wojciechpaderewski/Nixie_alarm_clock/docs/main/skroty/skroty.tex

% Created 2024-10-16 śro 21:35
% Intended LaTeX compiler: pdflatex
\documentclass[../main.tex]{subfiles}

% \usepackage[a4paper, margin=3cm]{geometry}
% \usepackage{amssymb} // not working

\usepackage[T1]{fontenc}
\usepackage[utf8]{inputenc}
\usepackage{graphicx}
\usepackage{longtable}
\usepackage{wrapfig}
\usepackage{rotating}
\usepackage[normalem]{ulem}
\usepackage{amsmath}
\usepackage{capt-of}
\usepackage{hyperref}
\usepackage{siunitx}
\usepackage{float}
\usepackage[polish]{babel}

\graphicspath{{../}}
\author{Wojciech Paderewski}
\date{\today}
\title{Koncepcja ukladu}
\hypersetup{
 pdfauthor={Wojciech Paderewski},
 pdftitle={Koncepcja ukladu},
 pdfkeywords={},
 pdfsubject={},
 pdflang={Polish}}

\begin{document}

\section*{Wykaz ważniejszych oznaczeń i skrótów}
\addcontentsline{toc}{section}{Wykaz ważniejszych oznaczeń i skrótów}
NTP - Network Time Protocol, protokół czasu sieciowego \\
Wi-Fi - Wireless Fidelity, bezprzewodowa łączność \\
RTC - Real Time Clock, zegar czasu rzeczywistego \\
I2C - Inter-Integrated Circuit, interfejs komunikacyjny \\
JTAG - Joint Test Action Group, interfejs programowania \\
USB - Universal Serial Bus, uniwersalna magistrala szeregowa \\
\end{document}
