wojciechpaderewski/Nixie_alarm_clock/docs/main/budowa_ukladu/encoder/encoder.tex

% Created 2024-10-16 śro 21:35
% Intended LaTeX compiler: pdflatex
\documentclass[../../main.tex]{subfiles}

% \usepackage[a4paper, margin=3cm]{geometry}
% \usepackage{amssymb} // not working

\usepackage[T1]{fontenc}
\usepackage[utf8]{inputenc}
\usepackage{graphicx}
\usepackage{longtable}
\usepackage{wrapfig}
\usepackage{rotating}
\usepackage[normalem]{ulem}
\usepackage{amsmath}
\usepackage{capt-of}
\usepackage{hyperref}
\usepackage{siunitx}
\usepackage{float}
\usepackage[polish]{babel}

\graphicspath{{../}}
\author{Wojciech Paderewski}
\date{\today}
\title{Koncepcja układu}
\hypersetup{
 pdfauthor={Wojciech Paderewski},
 pdftitle={Koncepcja układu},
 pdfkeywords={},
 pdfsubject={},
 pdflang={Polish}}

\begin{document}

Jedynymi kryteriami wyboru enkodera obrotowego były napięcie zasilania oraz to, by posiadał on przycisk.
Wybrano encoder PEC12R\-41BBF\-S0012 firmy Bourns \cite{st:encoder}. Jest to 2-kanałowy encoder o rozdzielczości 12 impulsów na obrót. 
Jego napięcie robocze wynosi 5 V. Producent w karcie katalogowej informuje również, jakie filtry zastosować, aby zapobiec zakłóceniom.
Schemat zalecany przez producenta przedstawiono na rysunku \ref{fig:encoder_karta}.

\begin{figure}[H]
    \centering
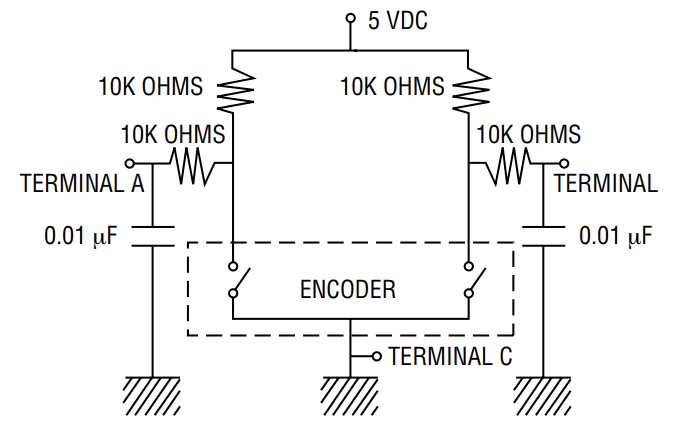
[picture p26: docs/main/budowa_ukladu/encoder/encoder_karta.png]
    
    \caption{Schemat filtrów zalecany przez producenta \cite{st:encoder}}
    \label{fig:encoder_karta}
\end{figure}

Dodatkowo dodano filtr dolnoprzepustowy przy przycisku enkodera, aby zapobiec drganiom styków i nie musieć implementować debouncingu w oprogramowaniu.
Schemat elektryczny podłączenia enkodera obrotowego przedstawiono na rysunku \ref{fig:encoder}.
\begin{figure}[H]
    \centering
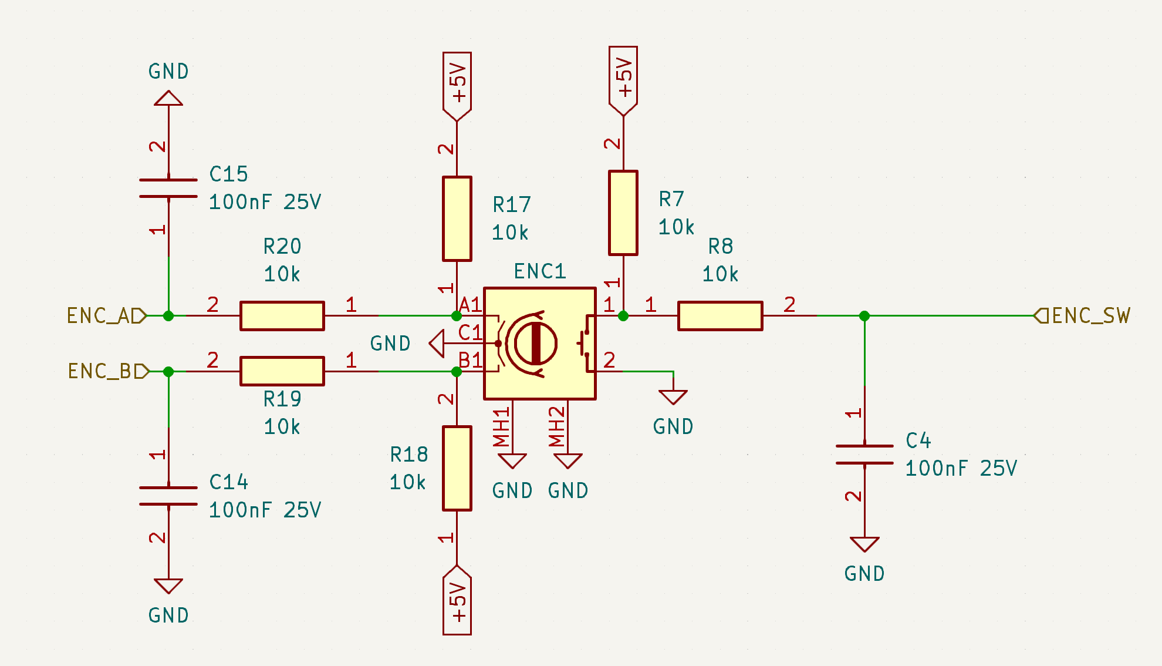
[picture p27: docs/main/budowa_ukladu/encoder/encoder.png]
    
    \caption{Schemat elektryczny enkodera obrotowego}
\end{figure}

\end{document}
