wojciechpaderewski/Nixie_alarm_clock/docs/raport/documentation.pdf

Kluczowe parametry zastosowanych lamp nixie

- Napięcie zapłonu: 170 V
- Napięcie pracy: 140 V
- Napięcie wygaszania: 120 V
- Prąd katodowy średni: 2 mA
- minimalny prąd katodowy: 1.5 mA
- maksymalny prąd katodowy: 2.5 mA

1
