wojciechpaderewski/Nixie_alarm_clock/docs/raport/raport.pdf

# Raport ze wstępnego etapu prac

## 1 Zdobycie kluczowego elementu projektu - lamp nixie

Udało się zakupić lampy nixie w ilości 6 sztuk. Są to lampy typu Z570N, produkcji niemieckiej. Był problem z dostępnością lamp, jednak udało się je zakupić używane w dobrym stanie w rozsądnej cenie.

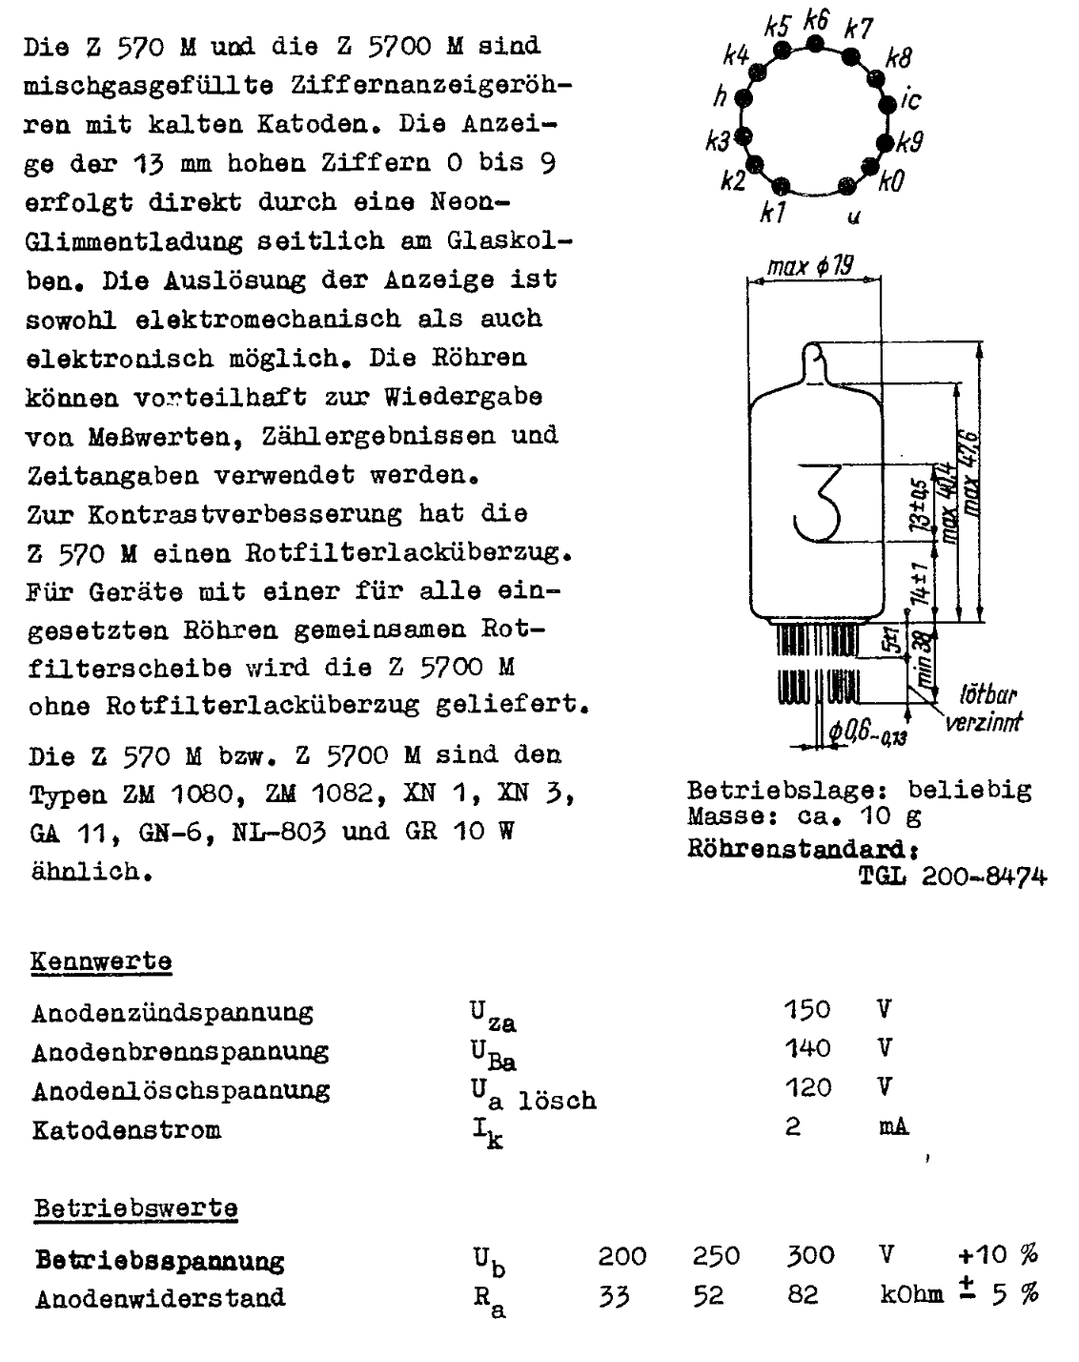
[picture p35: figure]

Rys. 1. Fragment dokumentacji lampy nixie Z570M

## 2 Opracowanie kluczowych założeń projektu

Zegar ma być zasilany przez USB-C co wymusza zaprojektowanie konwertera zasilania z 5V na 170V co jest zadaniem trudniejszym niż z 12V na 170V

Konwerter ma mieć możliwość programowej regulacji jasności wyświetlaczy, co zostanie uzyskane poprzez regulowany dzielnik napięcia w obwodzie sprzężenia zwrotnego sterownika konwertera

By zrealizować funkcje budzika, zegar ma bedzie wyposażony w mały buzzer który będzie generował dźwięk alarmu, będzie również możliwość wykorzystania zewnętrznego głośnika bluetooth

By nie zaburzać estetyki zegara, przycisk wyłączania alarmu bedzie odzielnym modułem komyunikującym się z zegarem po jakimś prostym protokole który będzie zużywał jak najmniej energii, ponieważ przycisk będzie zasilany z baterii

Zegar ma być wyposażony w moduł WiFi, który będzie umożliwiał sterowanie zegarem z poziomu

1

Home Assistanta, wykorzystane będą prawodopodobnie dwa mikrokontrolery, jeden do obsługi wyświetlaczy i przycisków, drugi n którym będzie zainstalowany ESPhome, który będzie komunikował się z Home Assistantem, a mikrokontrolery będą się komunikowac za pomocą UARTu

## 3 Wstępny model 3D zegara

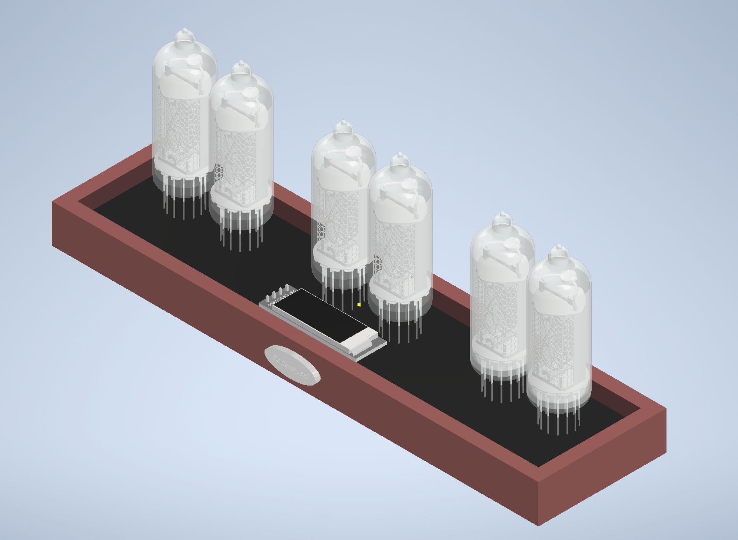
[picture p36: figure]

Rys. 2. Wstępny model 3D zegara rzut z góry

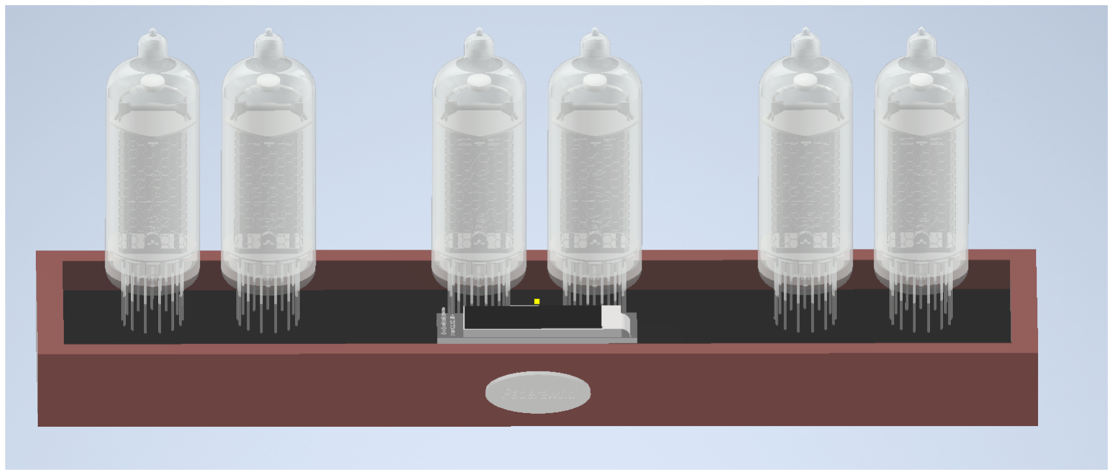
[picture p37: figure]

Rys. 3. Wstępny model 3D zegara rzut z przodu

Model jest tylko wstępnym zarysem, aby zwizualizować jakie materiały będą użyte i jak to bedzie wyglądać.
Materiały:
- Obudowa: drewno dębowe
- Pokrywa: szkło hartowane lub plexi (przyciemniane) ma być widoczna płytka drukowana
- Podstawa od spodu ma posiadać nóżki antypoślizgowe o odpowiedniej wysokości, by były widoczne ledy które będą od spodu podświetlać zegar

## 4 Początek projektowania konwertera

2
