wojciechpaderewski/Nixie_alarm_clock/docs/main/realizacja/obliczenia_mocy/obliczenia_mocy.pdf

By móc zaprojektować odpowiednie zasilanie dla całego układu, należy obliczyć szacunkową moc potrzebną do zasilania wszystkich komponentów. Poza lampami Nixie, najbardziej obciążającym elementem będzie pasek LED oraz mikrokontroler, pozostałe elementy będą pobierały znikome ilości prądu.
Założono maksymalną długość paska LED na 30 cm. Z deklaracji producenta paska LED wynika, że moc na metr wynosi 18W, co daje:

PLED = 18W m⁻¹
- 0.3 m = 5.4W | (0.1)

Następnie obliczono prąd potrzebny do zasilenia paska LED przy napięciu 5 V:

ILED =

PLED

ULED

=

5.4W
5 V
= 1.08 A | (0.2)

W dalszej kolejności obliczono moc potrzebną do zasilania mikrokontrolera ESP32-S3. Według producenta maksymalny pobór prądu wynosi 340 mA, co przy napięciu zasilania 3.3 V daje:

PESP32 = 340 mA · 3.3 V = 1.122W | (0.3)

Następnie policzono prąd pobierany przez wszystkie lampy, których jest 6 sztuk, przy prądzie katodowym 2 mA każda, co daje:

INixie = 6 · 2 mA = 12 mA | (0.4)

Jednak należy dodać jeszcze prąd potrzebny do zasilania kropek oraz separatorów, oszacowano prąd kropki na 1 mA oraz separatora na 1 mA, co daje:

INixie = 6 · 2 mA + 6 · 1 mA + 2 · 1 mA = 20 mA | (0.5)

Dalszym krokiem było obliczenie mocy potrzebnej do zasilania lampy nixie, przy napięciu 220 V oraz prądzie 20 mA, zakładając sprawność przetwornicy na poziomie 70 %:

PNixie =

UNixie · INixie
Sprawność =

220 V · 20 mA
0.7
= 6.29W | (0.6)

Pozostałe komponenty będą pobierały znikome ilości prądu, więc nie będą brane pod uwagę w obliczeniach. Szacunkowa moc potrzebna do zasilania całego układu wynosi:

Pcałkowita = PLED + PESP32 + PNixie = 5.4W + 1.122W + 6.29W = 12.812W (0.7)

Sumarycznie szacunkowa moc potrzebna do zasilania całego układu wynosi około 13W,

1
