wojciechpaderewski/Nixie_alarm_clock/docs/main/budowa_ukladu/12V_to_HV_conv/12V_to_HV_conv.pdf

Przetwornica impulsowa wysokiego napięcia jest najtrudniejszym do zaprojektowania elementem układu. Ma ona posiadać regulowane programowo napięcie wyjściowe, co dodatkowo komplikuje projekt. Nie może być również użyta zbyt duża cewka, ponieważ celem jest stworzenie niskiego urządzenia.

### 0.0.1 Założenia projektowe

- Napięcie wejściowe: 12 V
- Napięcie wyjściowe: 130-220 V
- Prąd wyjściowy: 20 mA
- 0.1 V tętnienia napięcia wyjściowego

### 0.0.2 Wybór układu scalonego

Wybrano układ LM3488 produkcji Texas Instruments, który jest układem przeznaczonym do budowy przetwornic typu Boost oraz Flyback. Jest to układ high efficiency, co jest powodem dla którego został wybrany [1].
Jako początkowe założenie przyjęto częstotliwość przełączania 400 kHz zgodnie z domyślną wartością w nocie katalogowej układu, ale możliwe jest zwiększanie częstotliwości do 1 MHz, co pozwala na zmniejszenie rozmiarów cewki oraz kondensatorów, natomiast może to pogorszyć sprawność układu, ponieważ według karty katalogowej wraz ze wzrostem częstotliwości spada wzmocnienie układu, co przekłada się na mniejszą sprawność. Podczas projektowania wzorowano się na schemacie z karty katalogowej, który przedstawiono na rysunku 0.1.

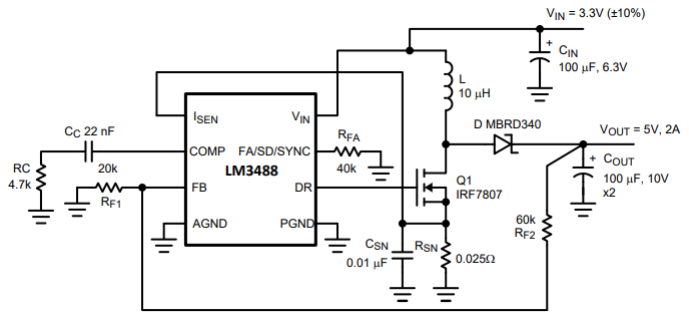
[picture p48: figure]

Figure 0.1: Schemat układu z karty katalogowej [1]

### 0.0.3 Dobór cewki

Wartość prądu cewki oszacowano na podstawie założonego prądu wyjściowego:

Il =

Vout · Iout

Vin

=

220 · 0.02
12
≈ 0.36 mA | (0.1)

Dodatkowe 30% prądu wyjściowego zostało dodane jako tętnienia prądu, co pozwala oszacować wartość maksymalnego prądu cewki:

Ipeak = (1 + 0.3) · Il = 1.3 · 0.36 ≈ 0.468 A | (0.2)

Wynika z tego, że potrzebna jest cewka o prądzie przewodzenia większym niż 0.5 A. Obliczono wypełnienie sygnału PWM, na podstawie wzoru:

D220 =

Vout − Vin

Vout

=

220 − 12
220
≈ 0.945 | (0.3)

D130 =

Vout − Vin

Vout

=

130 − 12
130
≈ 0.908 | (0.4)

Zgodnie z kartą katalogową układu LM3488, cewka powinna mieć wartość określaną wzorem:

L > D(1 − D)Vin

2fswIout

(0.5)

Według dokumentacji Iout podczas obliczeń powinno stanowić 30% minimalnej wartości prądu wyjściowego:
Iout = 0.3 · 20 mA = 6 mA | (0.6)

Dla napięcia wyjściowego 220 V oraz napięcia wejściowego 12 V oraz częstotliwości 400 kHz otrzymano wartość cewki:

L220 >

0.945 · (1 − 0.945) · 12
2 · 400000 · 0.006
≈ 128.9 µH | (0.7)

Natomiast dla napięcia wyjściowego 130V oraz napięcia wejściowego 12 V oraz częstotliwości 400 kHz otrzymano wartość cewki:

L130 >

0.908 · (1 − 0.908) · 12
2 · 400000 · 0.006
≈ 209.5 µH | (0.8)

Napotkano problem z doborem cewki, ponieważ nie udało się znaleźć w sklepie cewki o wartości powyżej 200 µH w rozsądnej cenie i odpowiednich rozmiarach. Dlatego zdecydowano się na zastosowanie cewki o wartości 180 µH, która jest najbliższą wartością dostępną w sklepie. Wartość graniczna prądu cewki wynosi 0.9 A, co jest wystarczającym zapasem. Wybrana cewka ma rezystancję 6.3 mΩ. Moc strat w cewce wynosi:

Pl = I

2

peak · R = 0.468²

- 0.0063 ≈ 1.4 mW | (0.9)

W celu osiągnięcia założonego zakresu napięcia wyjściowego z użyciem wybranej cewki, zdecydowano się na zwiększanie częstotliwości przełączania do 500 kHz. Obliczono wartość cewki dla napięcia wyjściowego 130 V oraz napięcia wejściowego 12 V oraz częstotliwości 500 kHz:

L220 >

0.945 · (1 − 0.945) · 12
2 · 500000 · 0.006
≈ 103.1 µH | (0.10)

L130 >

0.908 · (1 − 0.908) · 12
2 · 500000 · 0.006
≈ 167.6 µH | (0.11)

Z obliczeń wynika, że zwiększanie częstotliwości pozwala na zmniejszenie wartości cewki, co pozwala na zastosowanie cewki o wartości 180 µH.

### 0.0.4 Dobór kondensatorów

Według zaleceń z karty katalogowej w przetwornicy powinny być zastosowane kondensatory o jak najniższym ESR, dlatego odrzucono kondensatory elektrolityczne na rzecz kondensatorów ceramicznych, które mają bardzo niski ESR, tak mały że producent nie podaje tej wartości w notach katalogowych, gdyż jest ona zbyt mała by miała znaczenie.

Jednak problemem jest znalezienie kondensatorów ceramicznych pracujących przy wysokim napięciu, mimo tego został znaleziony kondensator ceramiczny o wartości 2.2 µF i napięciu pracy
do 250 V.
W obliczeniach należy uwzględnić spadek pojemności kondensatora wraz ze wzrostem napięcia. Wartości spadku pojemności dla kondensatora ceramicznego odczytano z [st:ceramic-capacitor].


Figure 0.2: Spadek pojemności kondensatora ceramicznego wraz ze wzrostem napięcia [2]

Wybrany kondensator jest klasy 2, wykonany z materiału X7R, co oznacza, że jego pojemność spadnie w przybliżeniu o 30% dla napięcia 220 V. Zdecydowano się na zastosowanie 2 kondensatorów o wartości 2.2 µF połączonych równolegle w celu zminimalizowania tętnień napięcia wyjściowego. Ostatecznie pojemność oszacowana na:

C220 = 2 · (1 − 0.3) · 2.2 µF = 3.08 µF | (0.12)

Obliczono tętnienia dla dobranych wartości kondensatorów:

∆V220 =

Vout
2 ·

Vout
Iout
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
0.02 · 3.08µF

·

0.945
500000
≈ 6.1 mV | (0.13)

∆V130 =

Vout
2 ·

Vout
Iout
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
0.02 · 3.08µF

·

0.908
500000
≈ 5.89 mV | (0.14)

Wartości tętnień jest mniejsza niż założone 0.1 V, co oznacza, że dobrano odpowiednie wartości kondensatorów.

### 0.0.5 Dobór diody

Oszacowano prąd diody na podstawie wzoru z karty katalogowej:

Id =

Iout
1 − D

+ ∆Iout =

0.02
1 − 0.945
+ 0.006 ≈ 0.37 A | (0.15)

Dioda powina mieć prąd przewodzenia większy niż 0.4 A oraz być diodą szybko przełączającą, by zminimalizować straty w układzie.
Zdecydowano się na zastosowanie diody ES1G firmy Onsemi, która jest diodą super szybką, o prądzie przewodzenia 1 A, co jest wystarczające dla tego zastosowania. Dioda ta ma maksymalne napięcie wsteczne 400 V, co pozwala na bezpieczne zastosowanie w tym układzie.

### 0.0.6 Dobór tranzystora

Można założyć że prąd tranzystora to prąd cewki, czyli 20 mA. Zgodnie z kartą katalogową tranzystor powinien mieć następujące parametry:

- Napięcie minimalnie drain-source: 250 V
- Jak najmniejszy RDS(on)
- Prąd przewodzenia większy niż 0.5 A
- Niskie napięcie progowe VTH
- Jak najmniejszy ładunek bramki
- Wymaganego prąd bramki mniejszego niż 1 A

Zdecydowano się na zastosowanie tranzystora N-Channel MOSFET TPH5200FNH firmy Toshiba, który ma następujące parametry:

- Napięcie drain-source: 250 V
- RDS(on)

: 44 mΩ

- Prąd przewodzenia: 26 A
- Napięcie progowe: 2 V
- Ładunek bramki: 22 nC
- Rozpraszana moc: 2.5W

Średni prąd bramki potrzebny do załączenia tranzystora można obliczyć na podstawie wzoru:

Ig = Qg · fsw = 22 nC · 500000 = 11 mA | (0.16)

Tranzystor ten spełnia wszystkie założenia, a także ma bardzo niskie RDS(on)

, co pozwala na
zminimalizowanie strat w układzie. Moc wydzielana na tranzystorze można obliczyć na podstawie wzoru:

Pmos = I

2
l
- RDS(on) = 0.468²
- 0.044 ≈ 0.01W | (0.17)

Moc jest bardzo niska, co oznacza, że tranzystor nie będzie się nagrzewał, a także nie będzie wymagał radiatora.

### 0.0.7 Ustawienie napięcia wyjściowego

Napięcie wyjściowe będzie regulowane, dlatego zdecydowano się na zastosowanie potencjometru cyfrowego włączonego w obwód sprzężenia zwrotnego. Potencjometr cyfrowy będzie się komunikował z mikrokontrolerem za pomocą magistrali I2C, co pozwoli na programowe ustawianie napięcia wyjściowego, by regulować jasność lamp.
Wybrano potencjometr cyfrowy MCP4018T-103E/LT firmy Microchip, który ma 128 poziomów ustawień, co pozwala na dokładne ustawienie napięcia wyjściowego, wybrano wartość 10 kΩ, co pozwala na uzyskanie odpowiedniego zakresu ustawień napięcia wyjściowego.
Zgodnie z kartą katalogową napięcie na pinie FB powinno wynosić 1.26 V, napięcie to oznacza, że napięcie wyjściowe jest odpowiednie. Po przetestowaniu kilku kombinacji zdecydowano się na zastosowanie następujących rezystorów:
- Rf b1 = 2.49 MΩ

- Rf b2 = 14.39 kΩ

Obliczone napięcie na wyjściu dla potencjometru z nastawą 10 kΩ:

Vout = 1.26 · (1 + Rf b1

Rf b2 + Rpot

) = 1.26 · (1 + | 2.49 MΩ
14.39 kΩ + 10 kΩ) ≈ 130.4 V | (0.18)

Obliczone napięcie na wyjściu dla potencjometru z nastawą 0Ω:

Vout = 1.26 · (1 + Rf b1

Rf b2 + Rpot

) = 1.26 · (1 + 2.49 MΩ
14.39 kΩ) ≈ 220.6 V | (0.19)

Uzyskano zakres napięcia wyjściowego od 130.4 V do 220.6 V, co jest zgodne z założeniami projektowymi.

### 0.0.8 Dobór rezystora ograniczającego prąd

Układ ma możliwość ustawienia limitu prądu jaki będzie płynąć przez tranzystor, co jest dodatkowym zabezpieczeniem przed uszkodzeniem tranzystora.
Najpierw obliczono wartość limitu szczytowego prądu przełączania zgodnie z kartą katalogową:

ISWlimit =

Iout
1 − D

+

D · Vin
2 · fsw · L
=
0.02
1 − 0.945

+

0.945 · 12
2 · 500000 · 180 µH
≈ 0.426 A (0.20)

Następnie obliczono wartość rezystora ograniczającego prąd zgodnie z kartą katalogową:

Rsense =

VSENSE − (D · VSENSE · VSL−ratio)

ISWlimit

=

156 mV − (0.945 · 156 mV · 0.49) 0.426

≈ 74 mΩ
(0.21)
Następnie sprawdzono warunek na maksymalną wartość rezystora ograniczającego prąd:

Rsense <

2 · VSL · fsw · L

Vout − (2 · VIN )

=

2 · 92 mV · 500000 · 180 µH
220 − (2 · 12) | ≈ 84 mΩ | (0.22)

Zdecydowano się na zastosowanie rezystora o wartości 75 mΩ, który spełnia wszystkie założenia. Został również dodany kondensator o wartości 10 pF w celu zminimalizowania tętnień napięcia na rezystorze oraz rezystor kompensujący 100 Ω. Schemat elektryczny przetwornicy przedstawiono na rysunku 0.3.


Figure 0.3: Schemat elektryczny przetwornicy 12 V na wysokie napięcie
