wojciechpaderewski/Nixie_alarm_clock/docs/main/budowa_ukladu/buzzer/buzzer.pdf

Kryterium wyboru buzzera było jego napięcie zasilania, głośność oraz jak najmniejszy rozmiar. Wybrano buzzer CEM120342, który jest buzzerem piezoelektrycznym. Z noty katalogowej [1] wyp-

isano użyteczne parametry na etapie projektowania:

- Napięcie zasilania: 3-5 V
- Max prąd zasilania: 35 mA
- Częstotliwość: 2,048 kHz
- Głośność: 85 dB - 95 dB
- Średnica: 12 mm, wysokość: 8 mm
- Rezystancja: 42 Ω
- Typ montażu: THT

Buzzer został podłączony według schematu zalecanego przez producenta przedstawionego na rysunku 0.1.


Figure 0.1: Schemat zalecany przez producenta [1]

Do sterowania wykorzystano inny tranzystor. Użyto tranzystora, który służy do sterowania katodami kropek w lampach Nixie, by nie dodawać kolejnego elementu do projektu. Tranzystor ten ma prąd kolektora 80 mA, co jest wystarczające do sterowania buzzerem. Buzzer jest dostatecznie mały, jedyną wadą jest montaż THT, który ogranicza miniaturyzację płytki drukowanej. Schemat elektryczny złącza z buzzerem przedstawiono na rysunku 0.2.

1


Figure 0.2: Schemat elektryczny podłączenia buzzera

2
