wojciechpaderewski/Nixie_alarm_clock/docs/main/budowa_ukladu/DC_Plug/DC_Plug.pdf

### 0.0.1 Dobór złącza

W doborze złącza kluczowe kluczowa była jego wielkość oraz prąd, który jest w stanie przewodzić. Teoretyczna moc układu to 10W, co przy napięciu 12 V daje prąd 0.83 A. Złącze musi być w stanie przewodzić prąd 1.5A, by zapewnić bezpieczeństwo.
Wybrano złącze firmy Same Sky o symbolu PJ-094H-SMT-TR o styku 0.65x2.35 mm, które jest w stanie przewodzić prąd 2.5A, czyli więcej niż wystarczająco. Złącze jest bardzo niskie, jego wysokość to 3.5mm, co pozwala na zminimalizowanie wysokości zegara.

### 0.0.2 Opis podłączenia

Jako kondensatory filtrujące wykorzystano, 2 kondensatory o pojemności 100 µF w celu zminimalizowania zakłóceń niskich częstotliwości, oraz 1 kondensator o pojemności 100 nF w celu zminimalizowania zakłóceń wysokich częstotliwości.
Kondensatory 100 µF są kondensatorami tantalowymi, a kondensator 100 nF jest kondensatorem ceramicznym. Wykorzystano te rodzaje kondensatorów, ponieważ są to kondensatory o długiej żywotności, a także mają one małe rozmiar w przeciwieństwie do kondensatorów elektrolitycznych.

### 0.0.3 Zabezpieczenia ESD

W celu zabezpieczenia linii przed przepięciami, wykorzystano diodę Transila firmy Wurth Elektronik o symbolu 824045812. Dioda ta jest diodą TVS o napięciu przebicia 13.3 V, oraz napięciu stabilizacji 15 V. Dioda musi mieć jak najmniejsze napięcie przebicia, by skok napięcia nie uszkodził rejestrów przesuwnych HV, które są wrażliwe na napięcia powyżej 13.2 V.
Dioda ta została wybrana gdyż nie udało się znaleźć transila o napięciu stabilizacji 13 V. Ma ona również dużą pojemność, co powoduje, że nie jest ona zalecana do zastosowań z wysokimi częstotliwościami, jednak w tym przypadku nie jest to problemem, gdyż jest to tylko złącze zasilania o stałym napięciu. Schemat złącza zasilania przedstawiono na rysunku 0.1.

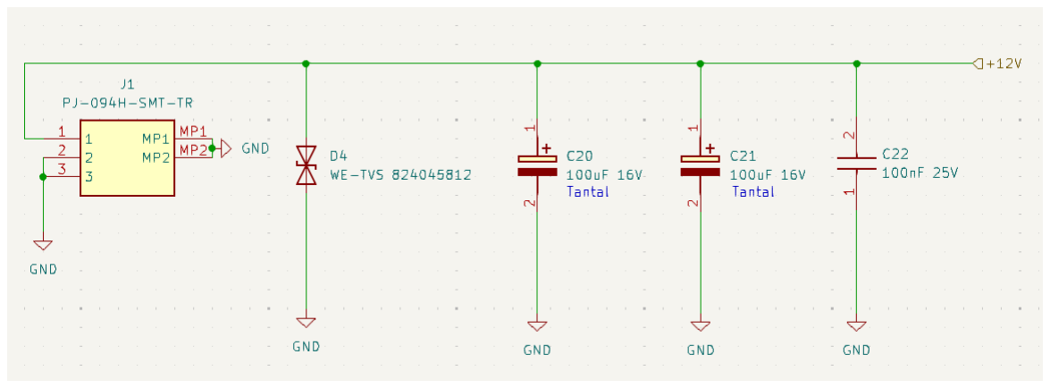
[picture p49: figure]

Figure 0.1: Schemat elektryczny złącza zasilania

1
