wojciechpaderewski/Nixie_alarm_clock/docs/main/montaz/montaz.tex

% Created 2024-10-16 śro 21:35
% Intended LaTeX compiler: pdflatex
\documentclass[../main.tex]{subfiles}

% \usepackage[a4paper, margin=3cm]{geometry}
% \usepackage{amssymb} // not working

\usepackage[T1]{fontenc}
\usepackage[utf8]{inputenc}
\usepackage{graphicx}
\usepackage{longtable}
\usepackage{wrapfig}
\usepackage{rotating}
\usepackage[normalem]{ulem}
\usepackage{amsmath}
\usepackage{capt-of}
\usepackage{hyperref}
\usepackage{siunitx}
\usepackage{float}
\usepackage[polish]{babel}

\graphicspath{{../}}
\author{Wojciech Paderewski}
\date{\today}
\title{Montaż}
\hypersetup{
 pdfauthor={Wojciech Paderewski},
 pdftitle={Montaż},
 pdfkeywords={},
 pdfsubject={},
 pdflang={Polish}}

\begin{document}
\subsection{Projekt płytki drukowanej}
Do zaprojektowania płytki drukowanej wykorzystano open-source'owy program KiCad. Zdecydowano się na zastosowanie dwustronnej płytki drukowanej.
Ostatecznie udało się uzyskać płytkę o wymiarach 138x53 mm oraz szacowaną wysokość wraz z komponentami na poziomie 1 cm, 
co oznacza, że udało się osiągnąć cel wykonania jak najmniejszej płytki drukowanej.

W celu poprawy aspektów wizualnych płytki zamówiona została pozłacana płyta drukowana. Uzyskano też pozłacaną ramkę, która powstała przez 
nienakładanie soldermaski na krawędzie płytki. W taki sam sposób uzyskano pozłacane napisy. Płytka posiada cztery otwory montażowe na śruby M3.
Otwory montażowe płytki oraz otwory montażowe enkodera obrotowego są podłączone do masy, co pozwala na lepsze prowadzenie masy między warstwami płytki. W 
celu uzyskania jak najlepszego połączenia masy między warstwami użyto dużo przelotek między warstwami. Zabieg ten pozwala na
lepsze ekranowanie ścieżek, co powinno przyczynić się do zmniejszenia zakłóceń elektromagnetycznych. Na rysunkach \ref{fig:TOP} oraz \ref{fig:BOTTOM}
przedstawiono warstwy górna i dolna zaprojektowanej płytki drukowanej.

\begin{figure}[H]
    \centering
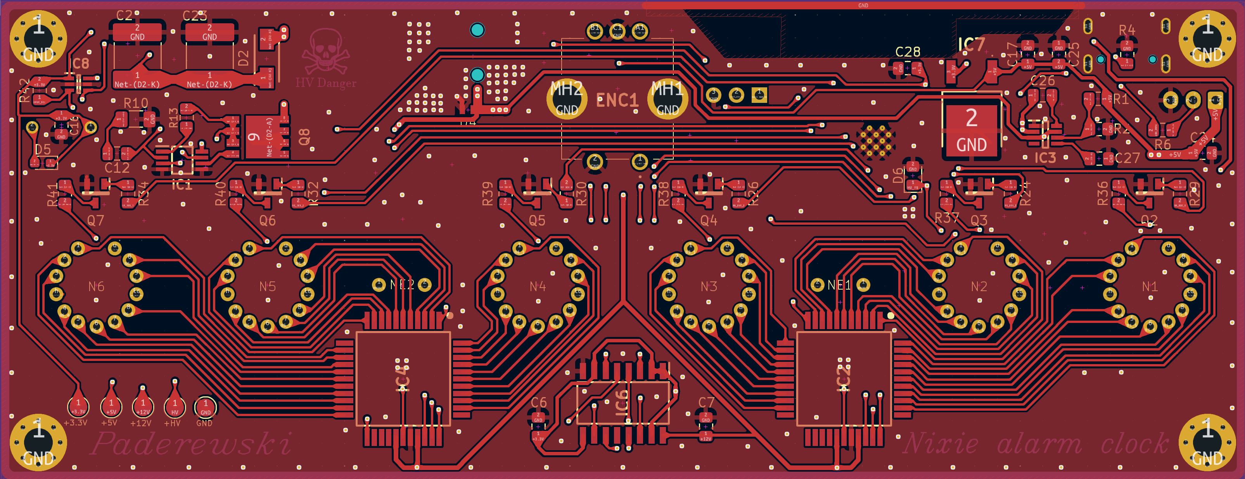
[picture p54: docs/main/montaz/TOP.png]
    
    \caption{Górna warstwa płytki drukowanej}
\end{figure}

\begin{figure}[H]
    \centering
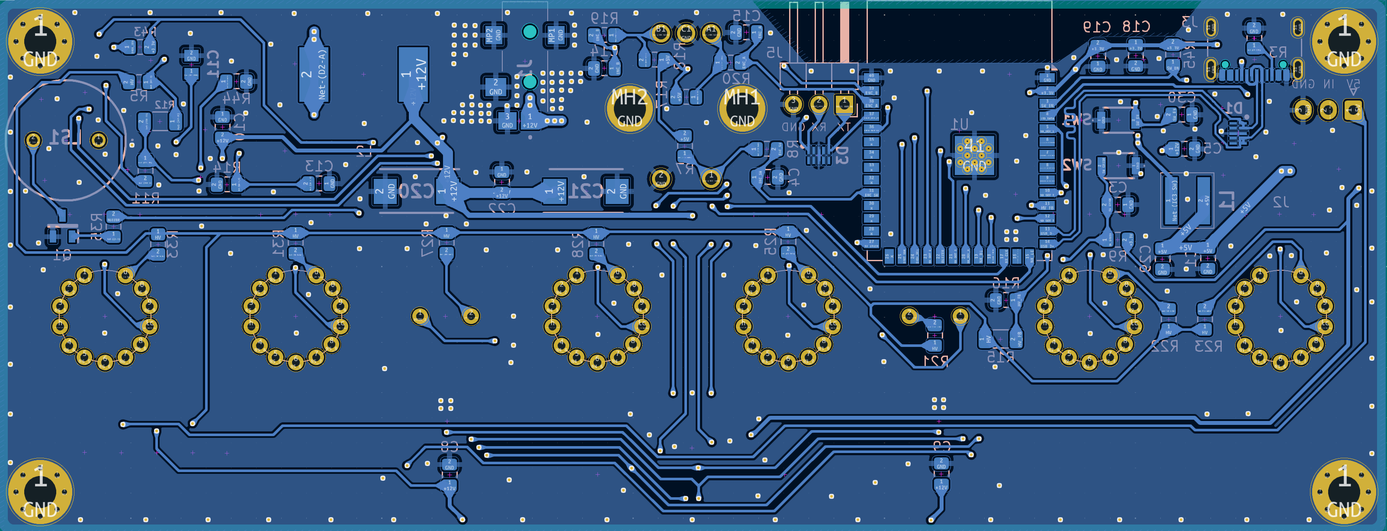
[picture p55: docs/main/montaz/BOTTOM.png]
    
    \caption{Dolna warstwa płytki drukowanej}
\end{figure}

\subsection{Montaż i uruchomienie układu}
Kolejnym etapem realizacji projektu był montaż elementów na płytce drukowanej.
Przed rozpoczęciem lutowania wszystkie pozłacane elementy
które ostały dodane jak elementy estetyczne, zostały zabezpieczone przed przypadkowym kontaktem z cyną, w wypadku gdyby cyna dostała się
na pozłacane elementy, nie udałoby się jej usunąć. Do zabezpieczenia wykorzystano taśmę kaptonową, która jest odporna na wysokie temperatury.

\begin{figure}[H]
    \centering
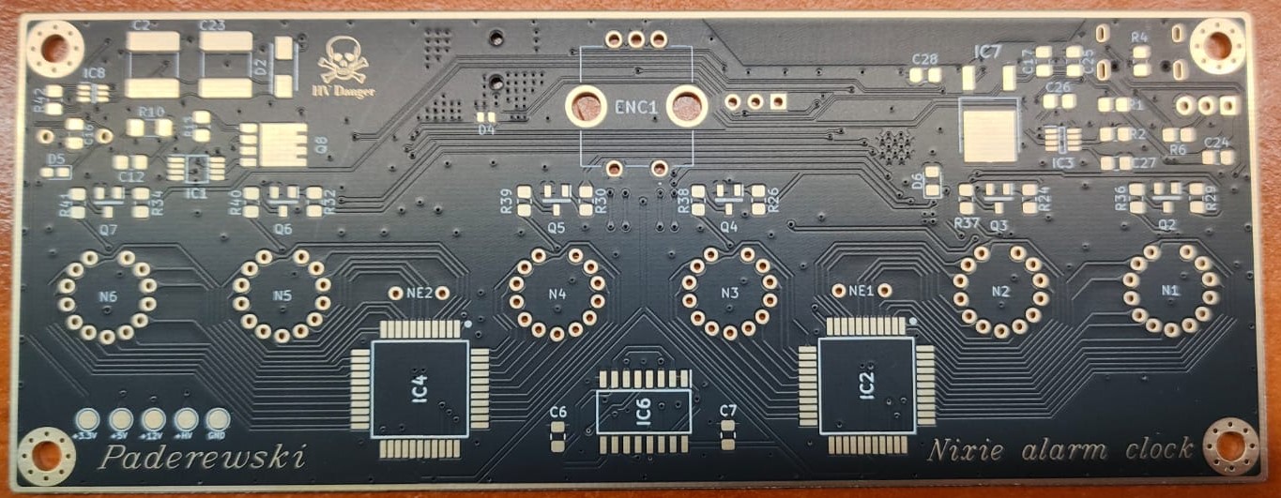
[picture p56: docs/main/montaz/przod.jpeg]
    
    \caption{Płytka drukowana - widok od góry}
    \label{fig:plytka_drukowana_1}
\end{figure}

\begin{figure}[H]
    \centering
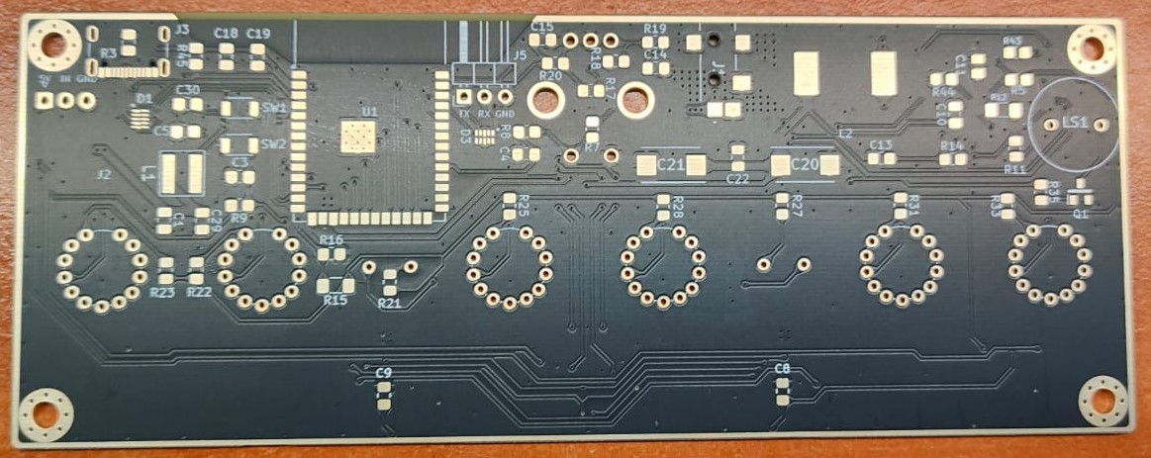
[picture p57: docs/main/montaz/tyl.jpeg]
    
    \caption{Płytka drukowana - widok od spodu}
    \label{fig:plytka_drukowana_2}
\end{figure}

Lutowanie rozpoczęto od elementów najmniejszych SMD (elementów montowanych powierzchniowo ). W celu łatwego lutowania elementów SMD, użyto pasty lutowniczej (flux)
oraz stacji lutowniczej na gorące powietrze (hot air). Po zlutowaniu elementów SMD, wyczyszczono płytkę z nadmiaru topnika, korzystającą z alkoholu izopropylowego. Następnym
krokiem było lutowanie elementów przewlekanych (THT). Ostatnim  mocowanym elementem były lampy Nixie, które trzeba było odpowiednio wypoziomować, by wszystkie lampy
były na tej samej linie. Lampy mają duże tolerancje produkcyjne, co powoduje że niektóre z lamp mogą być wyżej lub niżej niż pozostałe. W celu wypoziomowania lamp,
wykorzystano kątownik. Ostatnim etapem montażu było końcowe czyszczenie płytki z nadmiaru topnika. Zmontowane płytki drukowane przedstawiono na rysunkach \ref{fig:gora} oraz \ref{fig:dol}.

\begin{figure}[H]
    \centering
    
    \caption{Zmontowana płytka drukowana - widok od góry}
    \label{fig:gora}
\end{figure}

\begin{figure}[H]
    \centering
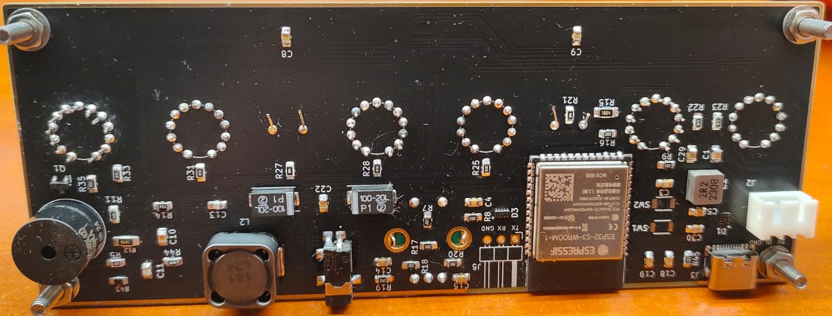
[picture p58: docs/main/montaz/dol.jpeg]
    
    \caption{Zmontowana płytka drukowana - widok od spodu}
    \label{fig:dol}
\end{figure}

\subsection{Uruchomienie układu}
Przetwornica wysokiego napięcia jako najtrudniejszy moduł układu, została odizolowana na etap pierwszego uruchomiania, w celu zminimalizowania ryzyka uszkodzenia lamp Nixie. Zrealizowano izolacje
poprzez nie przylutowanie rezystora 0 \si{\ohm} na linii łączącej przetwornicę z lampami Nixie. 

Przed podłączeniem zasilania, sprawdzono czy nie ma zwarcia na żadnej linii zasilania.
Po podłączeniu zasilania, sprawdzono napięcia na każdej z sekcji zasilania. Pomierzone napięcia były następujące:
\begin{itemize}
    \item linia 5 V - 5.081 V
    \item linia 3.3 V - 3.306 V
    \item linia 12 V - 12.01 V
    \item linia wysokiego napięcie - 162.1 V
\end{itemize}

Wszystkie napięcia są zgodne z wartościami oczekiwanymi. Napięcia są stabilne i nie obserwuje się żadnych skoków napięcia.
Ostatnim krokiem było dolutowanie rezystora 0 \si{\ohm} łączącego przetwornicę z lampami Nixie. Na \ref{fig:zmontowany_uklad} został przedstawiony zmontowany układ.

\begin{figure}[H]
    \centering
    
    \caption{Zmontowany układ}
    \label{fig:zmontowany_uklad}
\end{figure}

\end{document}
