wojciechpaderewski/Nixie_alarm_clock/docs/dokumentacje/Z570M.pdf

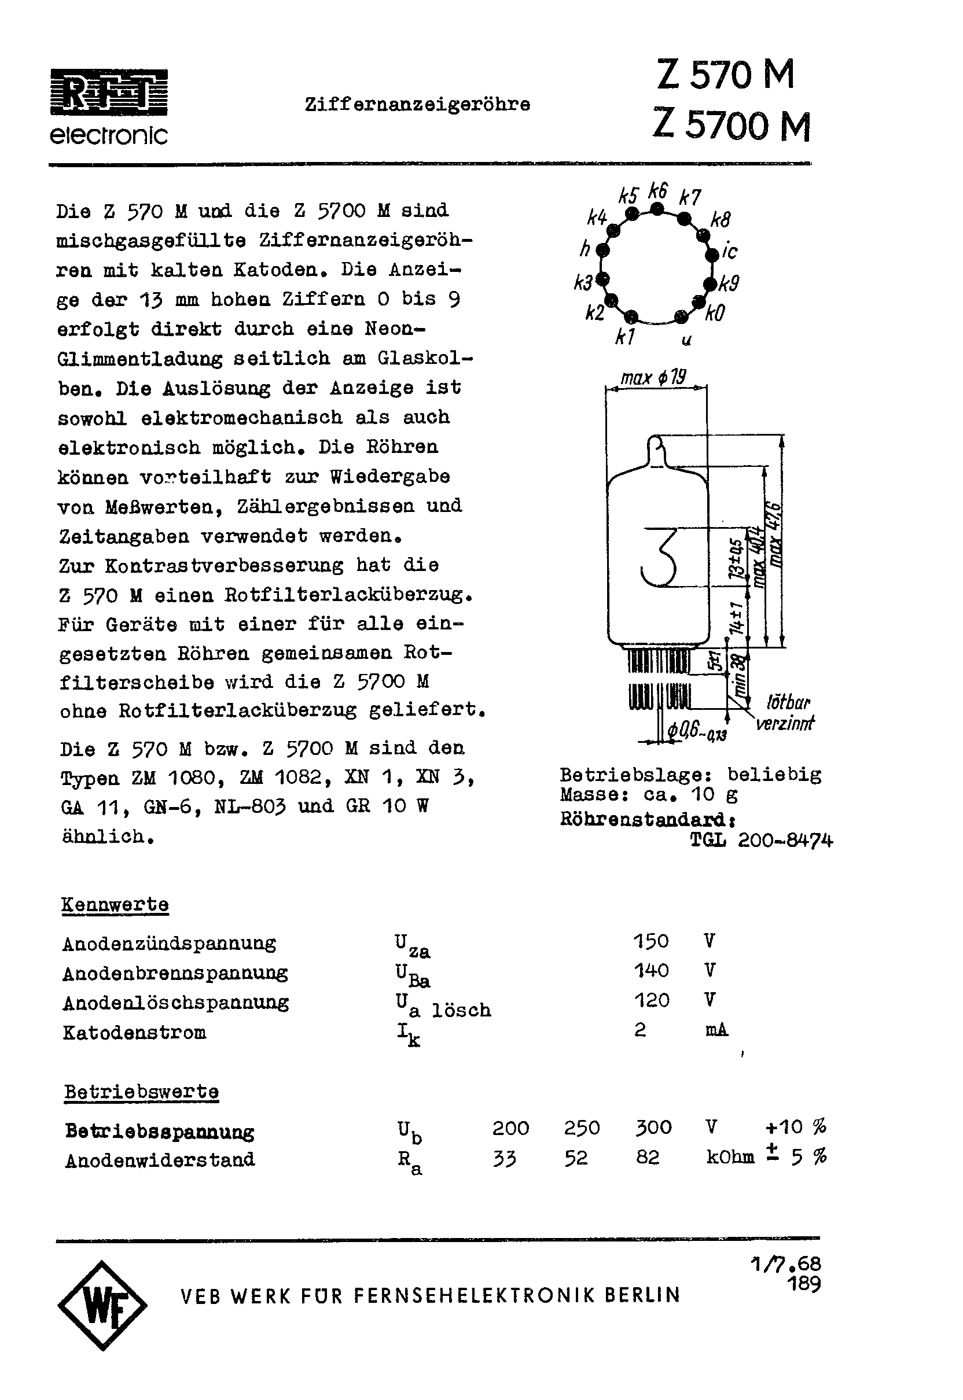
[picture p71: page 1]
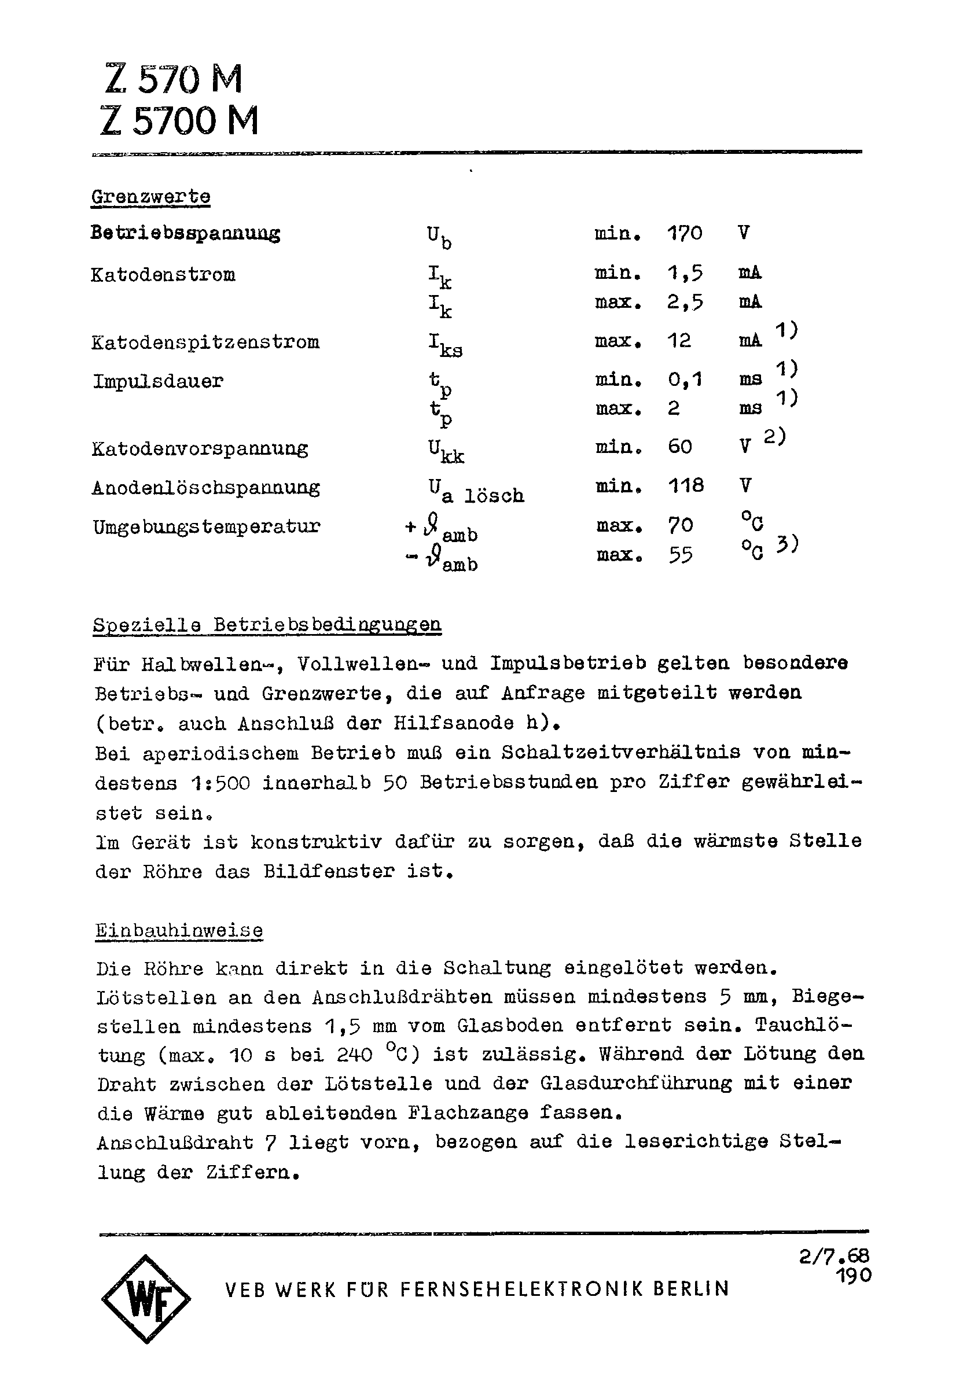
[picture p72: page 2]
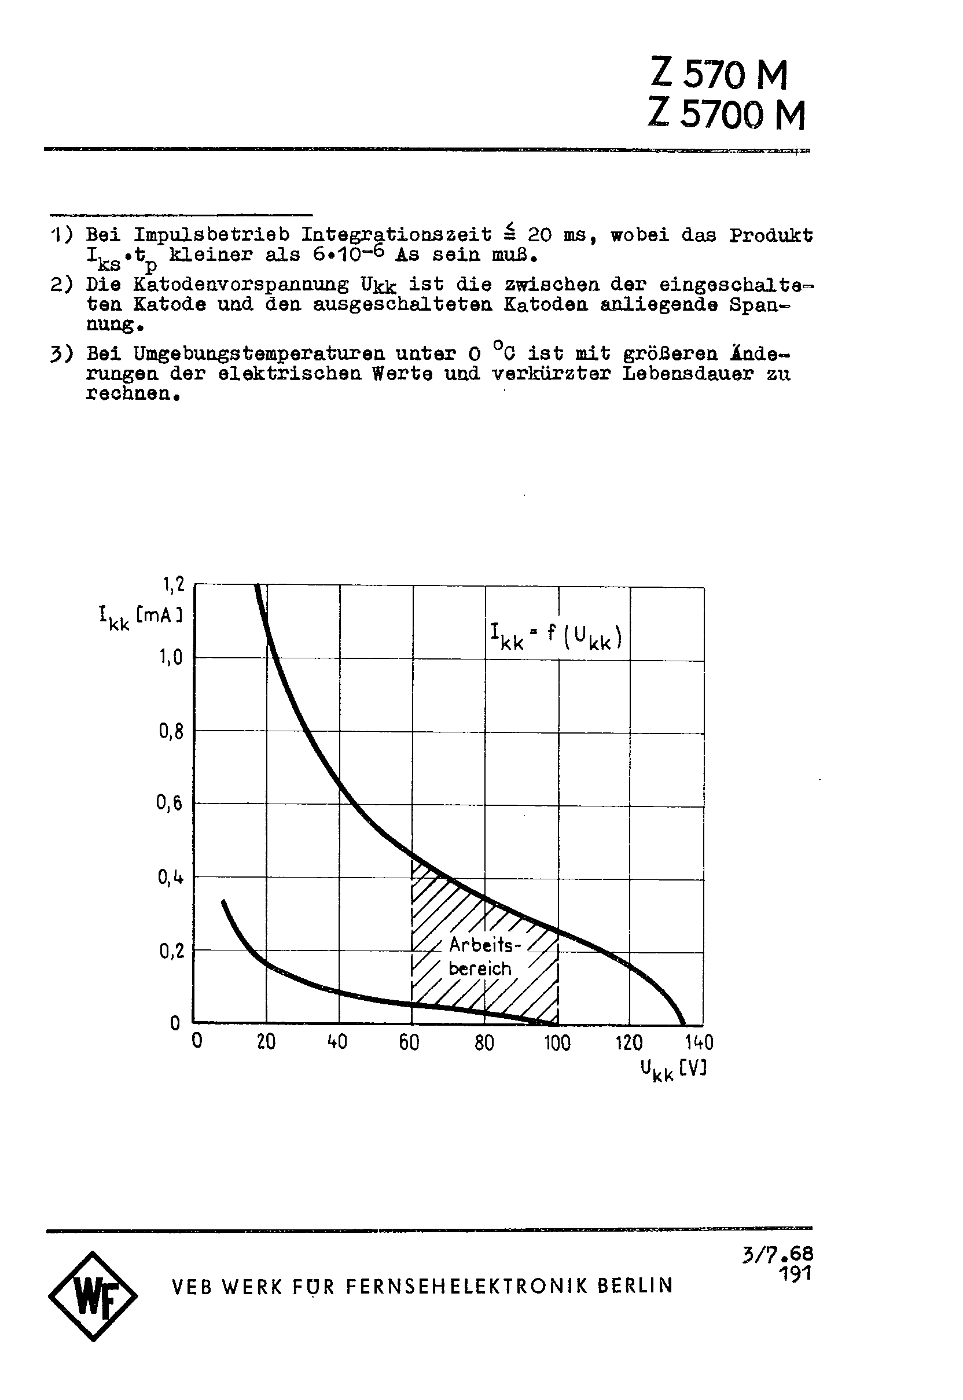
[picture p73: page 3]
