wojciechpaderewski/Nixie_alarm_clock/docs/main/koncepcja_ukladu/Nixie-concept.png

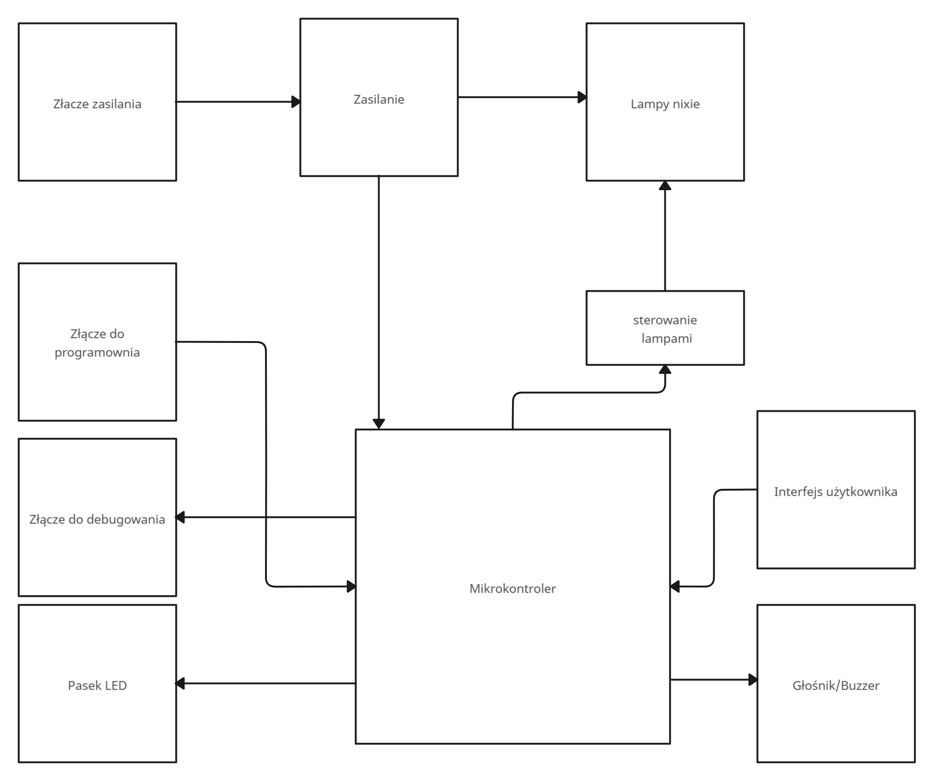
docs/main/koncepcja_ukladu/Nixie-concept.png
