wojciechpaderewski/Nixie_alarm_clock/desgin/nixie_alarm_main_board/nixie_alarm_main_board.kicad_pcb

## KiCad design desgin/nixie_alarm_main_board/nixie_alarm_main_board.kicad_pcb (2024-11-14)

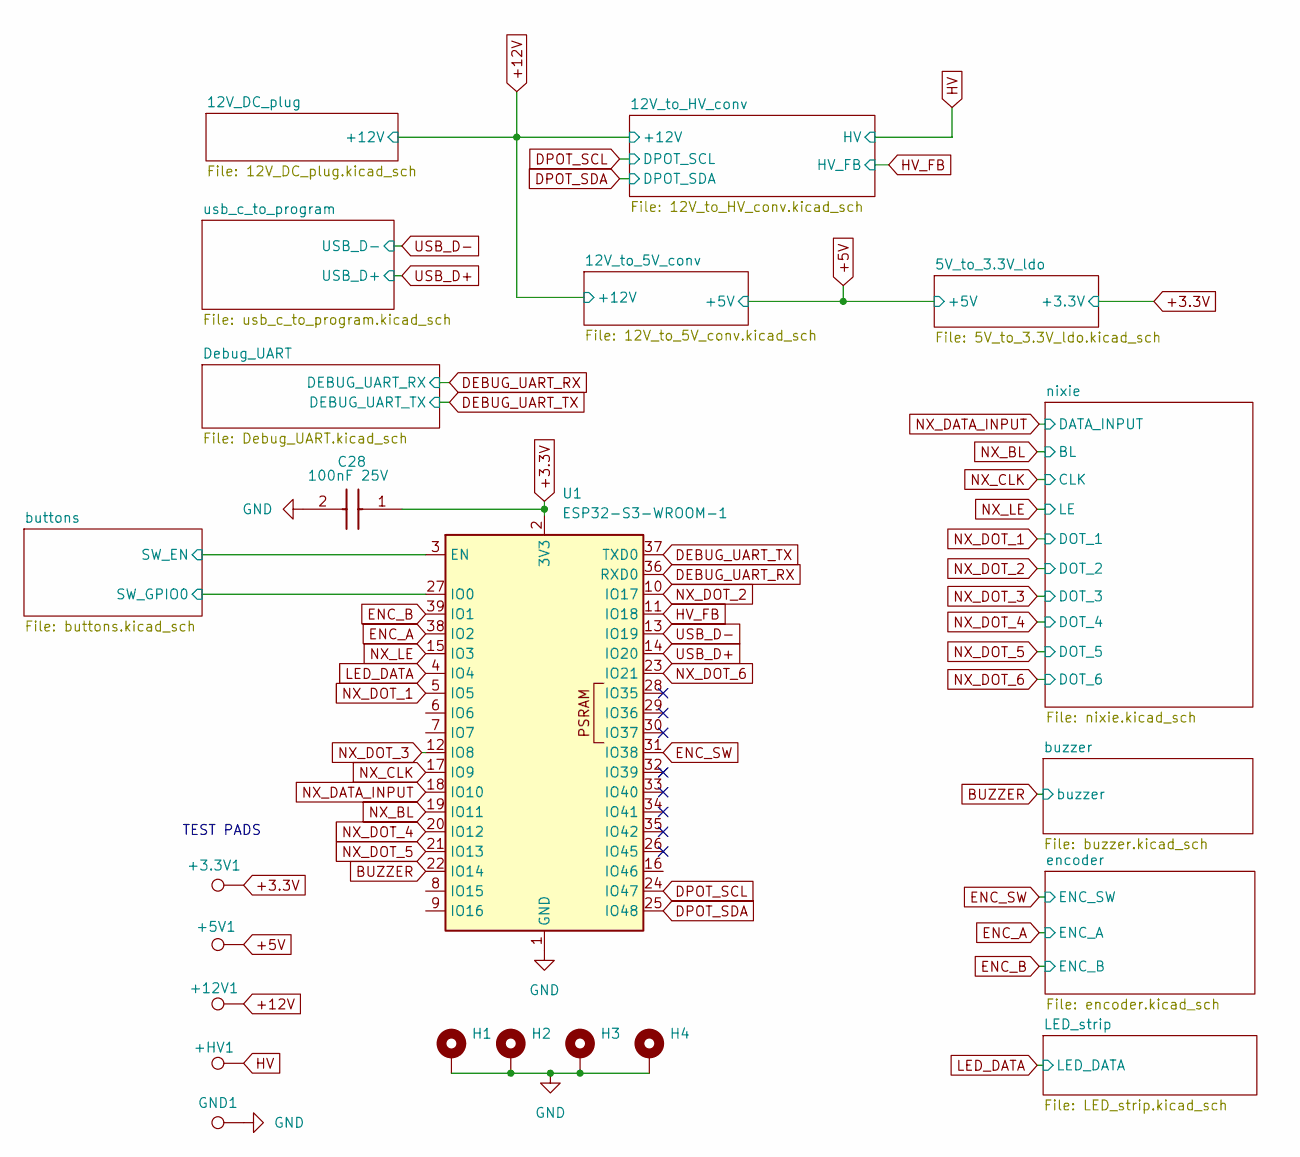
[picture p79: schematic nixie_alarm_main_board.kicad_sch]

Parts:
+3.3V1: +3.3V; TestPoint_Pad_D2.0mm
+5V1: +5V; TestPoint_Pad_D2.0mm
+12V1: +12V; TestPoint_Pad_D2.0mm
+HV1: +HV; TestPoint_Pad_D2.0mm
C28: 100nF 25V; C_0805_2012Metric_Pad1.18x1.45mm_HandSolder; Mouser Part Number 81-GRM033R71E101KA1J
GND1: GND; TestPoint_Pad_D2.0mm
H1, H2, H3, H4: MountingHole_Pad; MountingHole_3.2mm_M3_Pad_Via
U1: ESP32-S3-WROOM-1

Connections:
+3.3V: +3.3V1.1, C28.1, U1.2 (3V3); also elsewhere on the board
+5V: +5V1.1; also elsewhere on the board
+12V: +12V1.1; also elsewhere on the board
/buttons/SW_EN: U1.3 (EN); also elsewhere on the board
/buttons/SW_GPIO0: U1.27 (IO0); also elsewhere on the board
BUZZER: U1.22 (IO14); also elsewhere on the board
DEBUG_UART_RX: U1.36 (RXD0); also elsewhere on the board
DEBUG_UART_TX: U1.37 (TXD0); also elsewhere on the board
DPOT_SCL: U1.24 (IO47); also elsewhere on the board
DPOT_SDA: U1.25 (IO48); also elsewhere on the board
ENC_A: U1.38 (IO2); also elsewhere on the board
ENC_B: U1.39 (IO1); also elsewhere on the board
ENC_SW: U1.31 (IO38); also elsewhere on the board
GND: C28.2, GND1.1, H1.1, H2.1, H3.1, H4.1, U1.1 (GND), U1.40 (GND), U1.41 (GND); also elsewhere on the board
HV: +HV1.1; also elsewhere on the board
HV_FB: U1.11 (IO18); also elsewhere on the board
LED_DATA: U1.4 (IO4); also elsewhere on the board
NX_BL: U1.19 (IO11); also elsewhere on the board
NX_CLK: U1.17 (IO9); also elsewhere on the board
NX_DATA_INPUT: U1.18 (IO10); also elsewhere on the board
NX_DOT_1: U1.5 (IO5); also elsewhere on the board
NX_DOT_2: U1.10 (IO17); also elsewhere on the board
NX_DOT_3: U1.12 (IO8); also elsewhere on the board
NX_DOT_4: U1.20 (IO12); also elsewhere on the board
NX_DOT_5: U1.21 (IO13); also elsewhere on the board
NX_DOT_6: U1.23 (IO21); also elsewhere on the board
NX_LE: U1.15 (IO3); also elsewhere on the board
USB_D+: U1.14 (IO20); also elsewhere on the board
USB_D-: U1.13 (IO19); also elsewhere on the board

Notes on the sheet:
TEST PADS

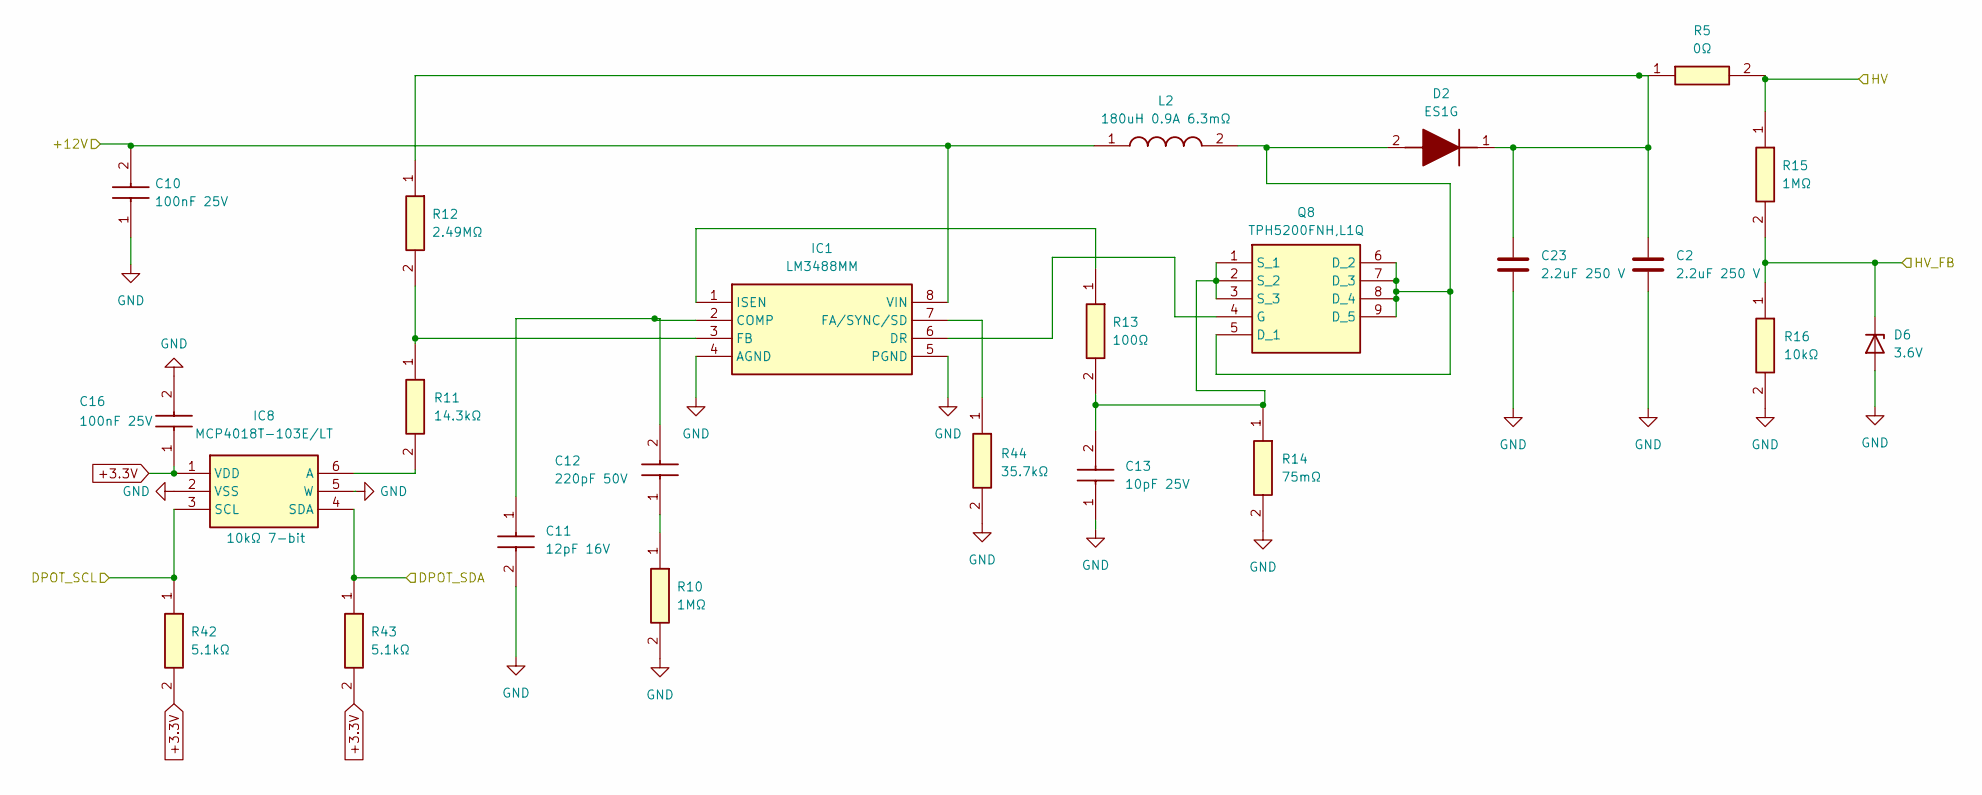
[picture p80: schematic 12V_to_HV_conv.kicad_sch]

Parts:
C2, C23: 2.2uF 250 V; C_2220_5750Metric_Pad1.97x5.40mm_HandSolder
C10, C16: 100nF 25V; C_0805_2012Metric_Pad1.18x1.45mm_HandSolder; Mouser Part Number 81-GRM033R71E101KA1J
C11: 12pF 16V; C0805; Mouser Part Number 80-C0805C332K5R
C12: 220pF 50V; C_0805_2012Metric_Pad1.18x1.45mm_HandSolder; Mouser Part Number 81-GRM033R71E101KA1J
C13: 10pF 25V; C_0805_2012Metric_Pad1.18x1.45mm_HandSolder; Mouser Part Number 81-GRM033R71E101KA1J
D2: ES1G; DIOM5227X260N; Mouser Part Number 512-ES1G
D6: 3.6V; D_0805_2012Metric_Pad1.15x1.40mm_HandSolder
IC1: LM3488MM; SOP65P490X110-8N; Mouser Part Number 926-LM3488MM
IC8: MCP4018T-103E/LT; SOT65P210X110-6N; Mouser Part Number 579-MCP4018T502ELT
L2: 180uH 0.9A 6.3mΩ; L_12x12mm_H6mm; Mouser Part Number 710-74437529203331
Q8: TPH5200FNH,L1Q; TPHR6503PL1LQ; Mouser Part Number 757-TPHR6503PL1LQ
R5: 0Ω; R_0805_2012Metric_Pad1.20x1.40mm_HandSolder; Mouser Part Number 71-CRCW0402-2.74K-E3
R10, R15: 1MΩ; R_1206_3216Metric_Pad1.30x1.75mm_HandSolder; Mouser Part Number 71-CRCW0402-2.74K-E3
R11: 14.3kΩ; R_0805_2012Metric_Pad1.20x1.40mm_HandSolder; Mouser Part Number 71-CRCW0402-2.74K-E3
R12: 2.49MΩ; R_1206_3216Metric_Pad1.30x1.75mm_HandSolder; Mouser Part Number 71-CRCW0402-2.74K-E3
R13: 100Ω; R_0805_2012Metric_Pad1.20x1.40mm_HandSolder; Mouser Part Number 71-CRCW0402-2.74K-E3
R14: 75mΩ; R_0805_2012Metric_Pad1.20x1.40mm_HandSolder; Mouser Part Number 667-ERJ-UP6D5101V
R16: 10kΩ; R_0805_2012Metric_Pad1.20x1.40mm_HandSolder; Mouser Part Number 71-CRCW0402-2.74K-E3
R42, R43: 5.1kΩ; R_0805_2012Metric_Pad1.20x1.40mm_HandSolder; Mouser Part Number 667-ERJ-UP6D5101V
R44: 35.7kΩ; R_0805_2012Metric_Pad1.20x1.40mm_HandSolder; Mouser Part Number 660-RK73H2ATTE1003F

Connections:
+3.3V: C16.1, IC8.1 (VDD), R42.2, R43.2; also elsewhere on the board
+12V: C10.2, IC1.8 (VIN), L2.1; also elsewhere on the board
DPOT_SCL: IC8.3 (SCL), R42.1; also elsewhere on the board
DPOT_SDA: IC8.4 (SDA), R43.1; also elsewhere on the board
GND: C2.2, C10.1, C11.2, C13.1, C16.2, C23.2, D6.2 (A), IC1.4 (AGND), IC1.5 (PGND), IC8.2 (VSS), IC8.5 (W), R10.2, R14.2, R16.2, R44.2; also elsewhere on the board
HV: R5.2, R15.1; also elsewhere on the board
HV_FB: D6.1 (K), R15.2, R16.1; also elsewhere on the board
unnamed: C12.1, R10.1
unnamed: D2.2 (A), L2.2, Q8.5 (D_1), Q8.6 (D_2), Q8.7 (D_3), Q8.8 (D_4), Q8.9 (D_5)
unnamed: C2.1, C23.1, D2.1 (K), R5.1, R12.1
unnamed: C11.1, C12.2, IC1.2 (COMP)
unnamed: IC1.6 (DR), Q8.4 (G)
unnamed: IC1.7 (FA/SYNC/SD), R44.1
unnamed: IC1.3 (FB), R11.1, R12.2
unnamed: IC1.1 (ISEN), R13.1
unnamed: IC8.6 (A), R11.2
unnamed: C13.2, Q8.1 (S_1), Q8.2 (S_2), Q8.3 (S_3), R13.2, R14.1

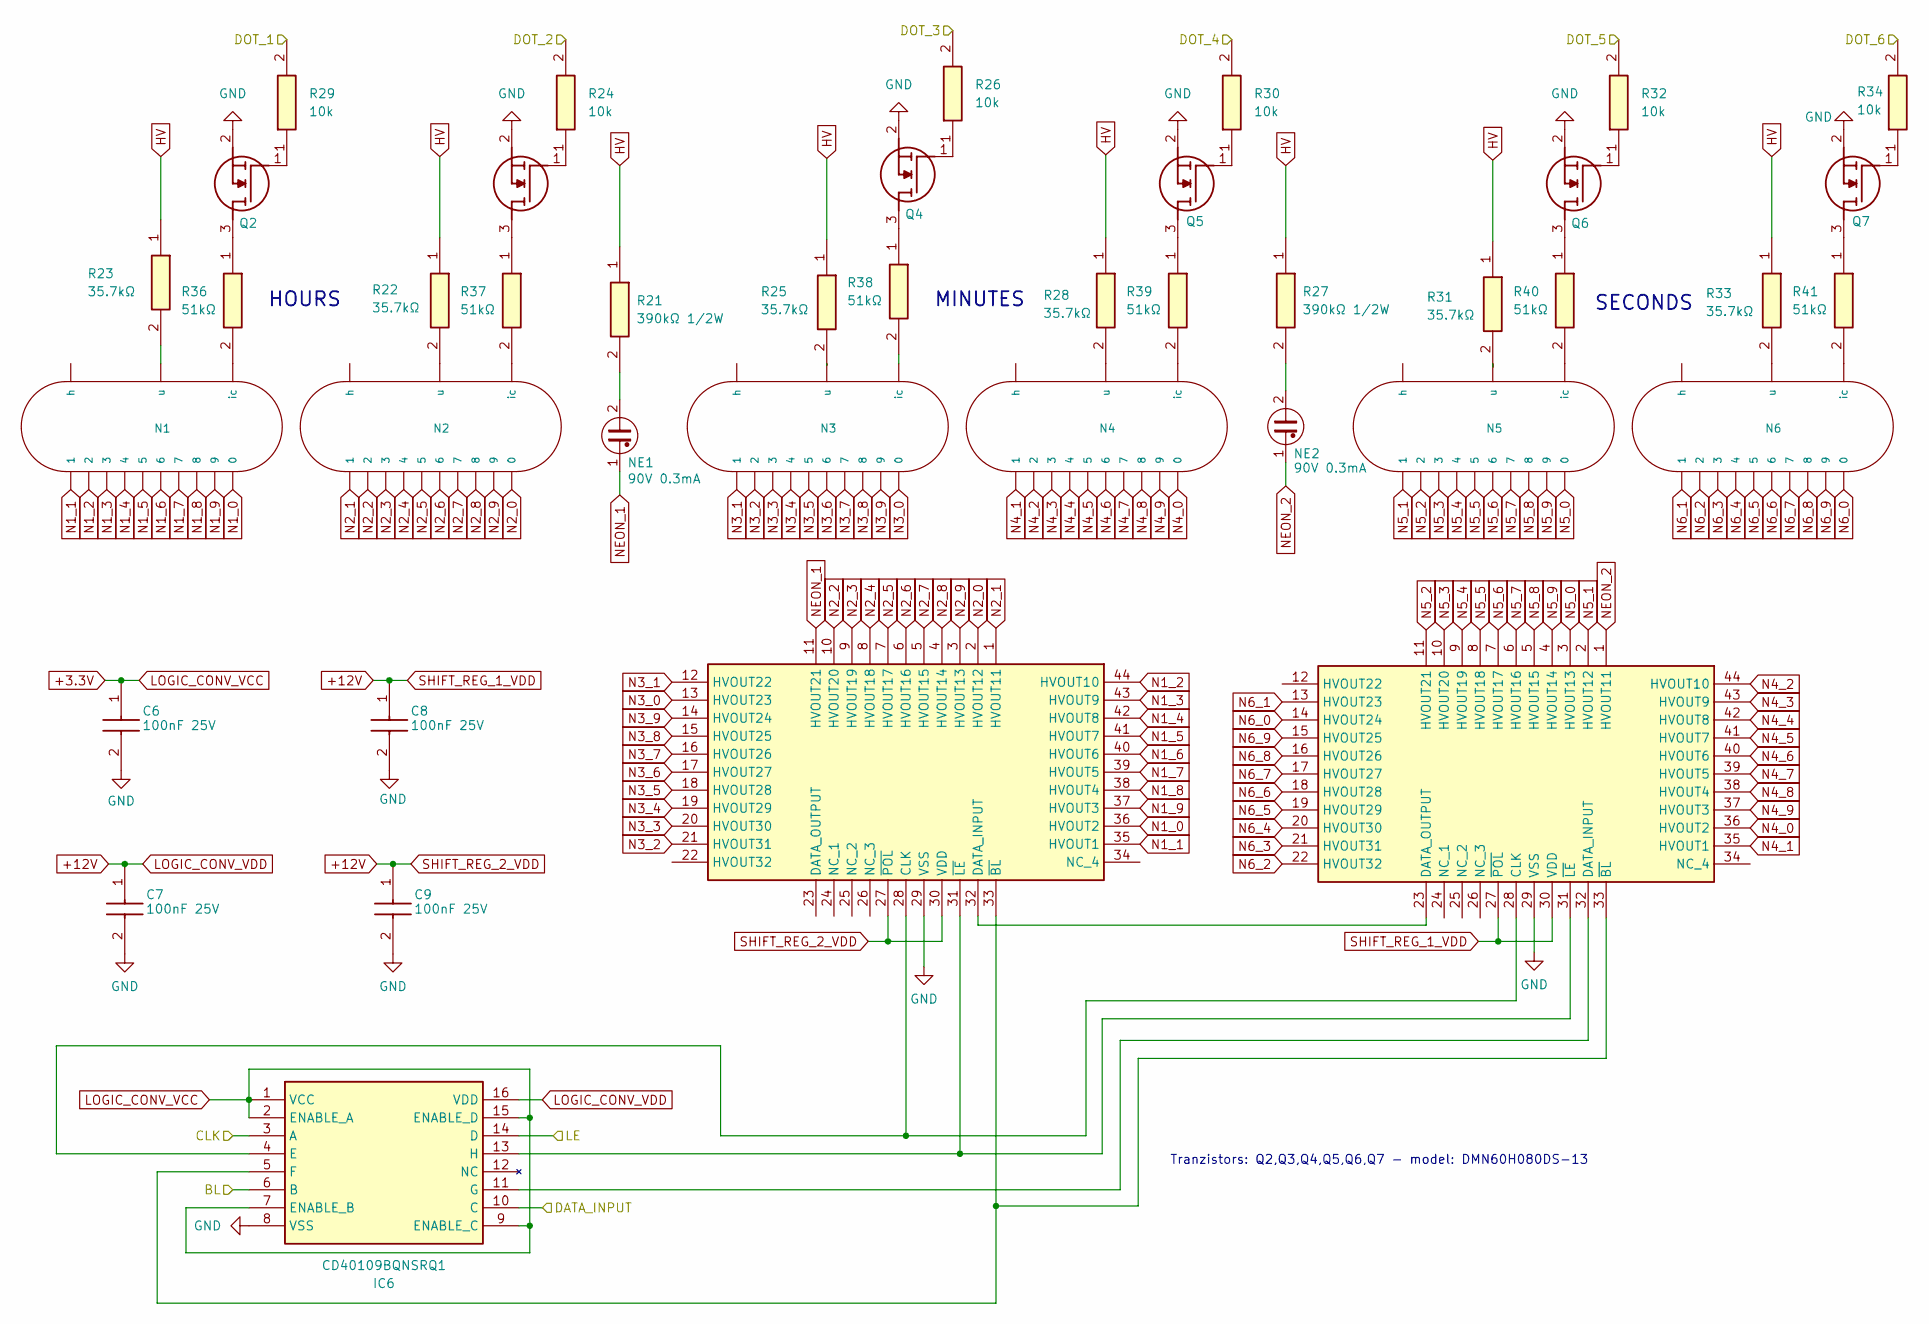
[picture p81: schematic nixie.kicad_sch]

Parts:
C6, C7, C8, C9: 100nF 25V; C_0805_2012Metric_Pad1.18x1.45mm_HandSolder; Mouser Part Number 81-GRM033R71E101KA1J
IC2, IC4: HV5530PG-G; QFP80P1390X1390X235-44N; Mouser Part Number 689-HV5530PG-G
IC6: CD40109BQNSRQ1; SOIC127P780X200-16N; Mouser Part Number 595-CD40109BQNSRQ1
N1, N2, N3, N4, N5, N6: Z570M
NE1, NE2: 90V 0.3mA; neon_lamp
Q2, Q3, Q4, Q5, Q6, Q7: DMN60H080DS-13; SOT96P240X110-3N; Mouser Part Number 621-DMN60H080DS-13
R21, R27: 390kΩ 1/2W; R_0805_2012Metric_Pad1.20x1.40mm_HandSolder; Mouser Part Number 660-RK73H2ATTE1003F
R22, R23, R25, R28, R31, R33: 35.7kΩ; R_0805_2012Metric_Pad1.20x1.40mm_HandSolder; Mouser Part Number 660-RK73H2ATTE1003F
R24, R26, R29, R30, R32, R34: 10k; R_0805_2012Metric_Pad1.20x1.40mm_HandSolder; Mouser Part Number 667-ERJ-UP6D5101V
R36, R37, R38, R39, R40, R41: 51kΩ; R_0805_2012Metric_Pad1.20x1.40mm_HandSolder; Mouser Part Number 660-RK73H2ATTE1003F

Connections:
+3.3V: C6.1, IC6.1 (VCC), IC6.2 (ENABLE_A), IC6.7 (ENABLE_B), IC6.9 (ENABLE_C), IC6.15 (ENABLE_D); also elsewhere on the board
+12V: C7.1, C8.1, C9.1, IC2.27 (~POL), IC2.30 (VDD), IC4.27 (~POL), IC4.30 (VDD), IC6.16 (VDD); also elsewhere on the board
GND: C6.2, C7.2, C8.2, C9.2, IC2.29 (VSS), IC4.29 (VSS), IC6.8 (VSS), Q2.2 (S), Q3.2 (S), Q4.2 (S), Q5.2 (S), Q6.2 (S), Q7.2 (S); also elsewhere on the board
HV: R21.1, R22.1, R23.1, R25.1, R27.1, R28.1, R31.1, R33.1; also elsewhere on the board
N1_0: IC2.36 (HVOUT2), N1.0
N1_1: IC2.35 (HVOUT1), N1.1
N1_2: IC2.44 (HVOUT10), N1.2
N1_3: IC2.43 (HVOUT9), N1.3
N1_4: IC2.42 (HVOUT8), N1.4
N1_5: IC2.41 (HVOUT7), N1.5
N1_6: IC2.40 (HVOUT6), N1.6
N1_7: IC2.39 (HVOUT5), N1.7
N1_8: IC2.38 (HVOUT4), N1.8
N1_9: IC2.37 (HVOUT3), N1.9
N2_0: IC2.2 (HVOUT12), N2.0
N2_1: IC2.1 (HVOUT11), N2.1
N2_2: IC2.10 (HVOUT20), N2.2
N2_3: IC2.9 (HVOUT19), N2.3
N2_4: IC2.8 (HVOUT18), N2.4
N2_5: IC2.7 (HVOUT17), N2.5
N2_6: IC2.6 (HVOUT16), N2.6
N2_7: IC2.5 (HVOUT15), N2.7
N2_8: IC2.4 (HVOUT14), N2.8
N2_9: IC2.3 (HVOUT13), N2.9
N3_0: IC2.13 (HVOUT23), N3.0
N3_1: IC2.12 (HVOUT22), N3.1
N3_2: IC2.21 (HVOUT31), N3.2
N3_3: IC2.20 (HVOUT30), N3.3
N3_4: IC2.19 (HVOUT29), N3.4
N3_5: IC2.18 (HVOUT28), N3.5
N3_6: IC2.17 (HVOUT27), N3.6
N3_7: IC2.16 (HVOUT26), N3.7
N3_8: IC2.15 (HVOUT25), N3.8
N3_9: IC2.14 (HVOUT24), N3.9
N4_0: IC4.36 (HVOUT2), N4.0
N4_1: IC4.35 (HVOUT1), N4.1
N4_2: IC4.44 (HVOUT10), N4.2
N4_3: IC4.43 (HVOUT9), N4.3
N4_4: IC4.42 (HVOUT8), N4.4
N4_5: IC4.41 (HVOUT7), N4.5
N4_6: IC4.40 (HVOUT6), N4.6
N4_7: IC4.39 (HVOUT5), N4.7
N4_8: IC4.38 (HVOUT4), N4.8
N4_9: IC4.37 (HVOUT3), N4.9
N5_0: IC4.3 (HVOUT13), N5.0
N5_1: IC4.2 (HVOUT12), N5.1
N5_2: IC4.11 (HVOUT21), N5.2
N5_3: IC4.10 (HVOUT20), N5.3
N5_4: IC4.9 (HVOUT19), N5.4
N5_5: IC4.8 (HVOUT18), N5.5
N5_6: IC4.7 (HVOUT17), N5.6
N5_7: IC4.6 (HVOUT16), N5.7
N5_8: IC4.5 (HVOUT15), N5.8
N5_9: IC4.4 (HVOUT14), N5.9
N6_0: IC4.14 (HVOUT24), N6.0
N6_1: IC4.13 (HVOUT23), N6.1
N6_2: IC4.22 (HVOUT32), N6.2
N6_3: IC4.21 (HVOUT31), N6.3
N6_4: IC4.20 (HVOUT30), N6.4
N6_5: IC4.19 (HVOUT29), N6.5
N6_6: IC4.18 (HVOUT28), N6.6
N6_7: IC4.17 (HVOUT27), N6.7
N6_8: IC4.16 (HVOUT26), N6.8
N6_9: IC4.15 (HVOUT25), N6.9
NEON_1: IC2.11 (HVOUT21), NE1.1
NEON_2: IC4.1 (HVOUT11), NE2.1
NX_BL: IC6.6 (B); also elsewhere on the board
NX_CLK: IC6.3 (A); also elsewhere on the board
NX_DATA_INPUT: IC6.10 (C); also elsewhere on the board
NX_DOT_1: R29.2; also elsewhere on the board
NX_DOT_2: R24.2; also elsewhere on the board
NX_DOT_3: R26.2; also elsewhere on the board
NX_DOT_4: R30.2; also elsewhere on the board
NX_DOT_5: R32.2; also elsewhere on the board
NX_DOT_6: R34.2; also elsewhere on the board
NX_LE: IC6.14 (D); also elsewhere on the board
unnamed: IC2.28 (CLK), IC4.28 (CLK), IC6.4 (E)
unnamed: IC2.32 (DATA_INPUT), IC4.23 (DATA_OUTPUT)
unnamed: IC2.33 (~BL), IC4.33 (~BL), IC6.5 (F)
unnamed: IC2.31 (~LE), IC4.31 (~LE), IC6.13 (H)
unnamed: IC4.32 (DATA_INPUT), IC6.11 (G)
unnamed: N1.ic, R36.2
unnamed: N1.u, R23.2
unnamed: N2.ic, R37.2
unnamed: N2.u, R22.2
unnamed: N3.ic, R38.2
unnamed: N3.u, R25.2
unnamed: N4.ic, R39.2
unnamed: N4.u, R28.2
unnamed: N5.ic, R40.2
unnamed: N5.u, R31.2
unnamed: N6.ic, R41.2
unnamed: N6.u, R33.2
unnamed: NE1.2, R21.2
unnamed: NE2.2, R27.2
unnamed: Q2.3 (D), R36.1
unnamed: Q2.1 (G), R29.1
unnamed: Q3.3 (D), R37.1
unnamed: Q3.1 (G), R24.1
unnamed: Q4.3 (D), R38.1
unnamed: Q4.1 (G), R26.1
unnamed: Q5.3 (D), R39.1
unnamed: Q5.1 (G), R30.1
unnamed: Q6.3 (D), R40.1
unnamed: Q6.1 (G), R32.1
unnamed: Q7.3 (D), R41.1
unnamed: Q7.1 (G), R34.1

Notes on the sheet:
HOURS
Tranzistors: Q2,Q3,Q4,Q5,Q6,Q7 - model: DMN60H080DS-13
SECONDS
MINUTES

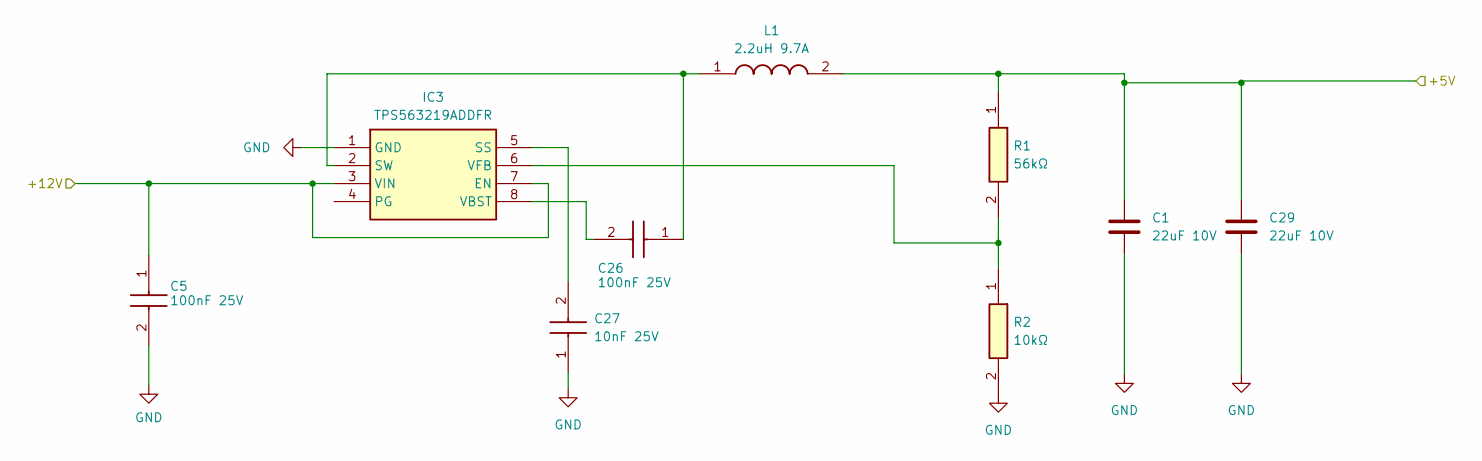
[picture p82: schematic 12V_to_5V_conv.kicad_sch]

Parts:
C1, C29: 22uF 10V; C_0805_2012Metric_Pad1.18x1.45mm_HandSolder
C5, C26: 100nF 25V; C_0805_2012Metric_Pad1.18x1.45mm_HandSolder; Mouser Part Number 81-GRM033R71E101KA1J
C27: 10nF 25V; C_0805_2012Metric_Pad1.18x1.45mm_HandSolder; Mouser Part Number 81-GRM033R71E101KA1J
IC3: TPS563219ADDFR; SOT65P280X110-8N; Mouser Part Number 595-TPS563219ADDFR
L1: 2.2uH 9.7A; SRP5030CA4R7M; Mouser Part Number 652-SRP5030CA-2R2M
R1: 56kΩ; R_0805_2012Metric_Pad1.20x1.40mm_HandSolder; Mouser Part Number 667-ERJ-UP6D5101V
R2: 10kΩ; R_0805_2012Metric_Pad1.20x1.40mm_HandSolder; Mouser Part Number 667-ERJ-UP6D5101V

Connections:
+5V: C1.1, C29.1, L1.2, R1.1; also elsewhere on the board
+12V: C5.1, IC3.3 (VIN), IC3.7 (EN); also elsewhere on the board
GND: C1.2, C5.2, C27.1, C29.2, IC3.1 (GND), R2.2; also elsewhere on the board
unnamed: C27.2, IC3.5 (SS)
unnamed: C26.1, IC3.2 (SW), L1.1
unnamed: C26.2, IC3.8 (VBST)
unnamed: IC3.6 (VFB), R1.2, R2.1

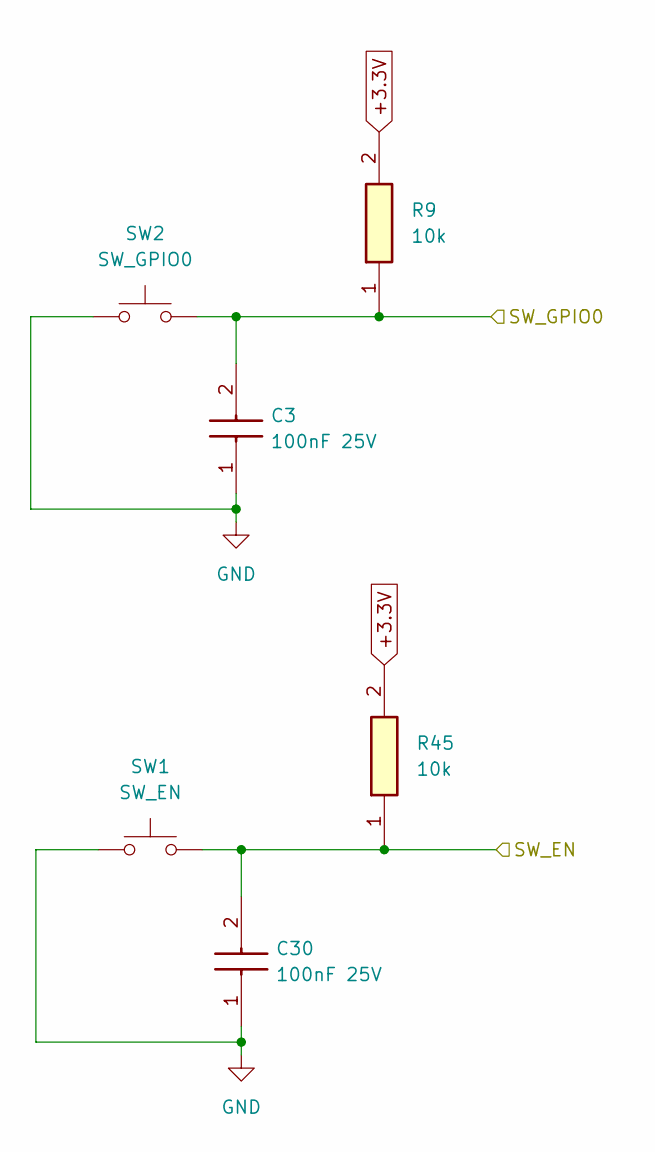
[picture p83: schematic buttons.kicad_sch]

Parts:
C3, C30: 100nF 25V; C_0805_2012Metric_Pad1.18x1.45mm_HandSolder; Mouser Part Number 81-GRM033R71E101KA1J
R9, R45: 10k; R_0805_2012Metric_Pad1.20x1.40mm_HandSolder; Mouser Part Number 667-ERJ-UP6D5101V
SW1: SW_EN; B3U1000PM
SW2: SW_GPIO0; B3U1000PM

Connections:
+3.3V: R9.2, R45.2; also elsewhere on the board
/buttons/SW_EN: C30.2, R45.1, SW1.2; also elsewhere on the board
/buttons/SW_GPIO0: C3.2, R9.1, SW2.2; also elsewhere on the board
GND: C3.1, C30.1, SW1.1, SW2.1; also elsewhere on the board

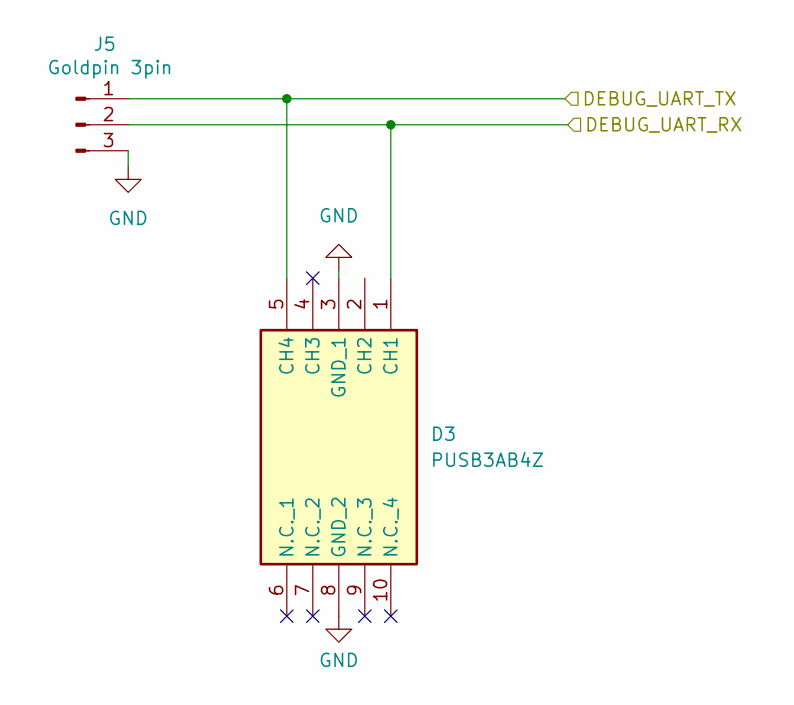
[picture p84: schematic Debug_UART.kicad_sch]

Parts:
D3: PUSB3AB4Z; SON50P100X250X50-10N; Mouser Part Number 771-PUSB3AB4Z
J5: Goldpin 3pin; PinHeader_1x03_P2.54mm_Horizontal

Connections:
DEBUG_UART_RX: D3.1 (CH1), J5.2; also elsewhere on the board
DEBUG_UART_TX: D3.5 (CH4), J5.1; also elsewhere on the board
GND: D3.3 (GND_1), D3.8 (GND_2), J5.3; also elsewhere on the board

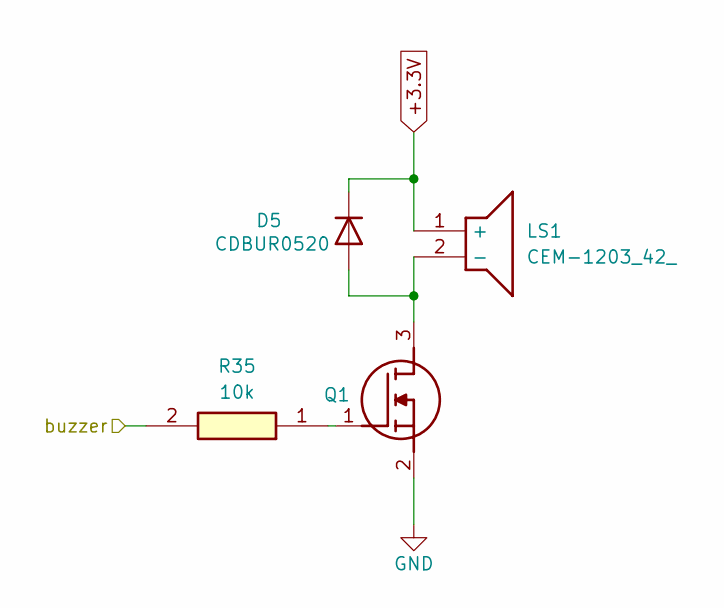
[picture p85: schematic buzzer.kicad_sch]

Parts:
D5: CDBUR0520; D_0603_1608Metric_Pad1.05x0.95mm_HandSolder
LS1: CEM-1203_42_; Mouser Part Number 490-CEM-1203(42)
Q1: DMN60H080DS-13; SOT96P240X110-3N; Mouser Part Number 621-DMN60H080DS-13
R35: 10k; R_0805_2012Metric_Pad1.20x1.40mm_HandSolder; Mouser Part Number 667-ERJ-UP6D5101V

Connections:
+3.3V: D5.1 (K), LS1.1 (+); also elsewhere on the board
BUZZER: R35.2; also elsewhere on the board
GND: Q1.2 (S); also elsewhere on the board
unnamed: D5.2 (A), LS1.2 (-), Q1.3 (D)
unnamed: Q1.1 (G), R35.1

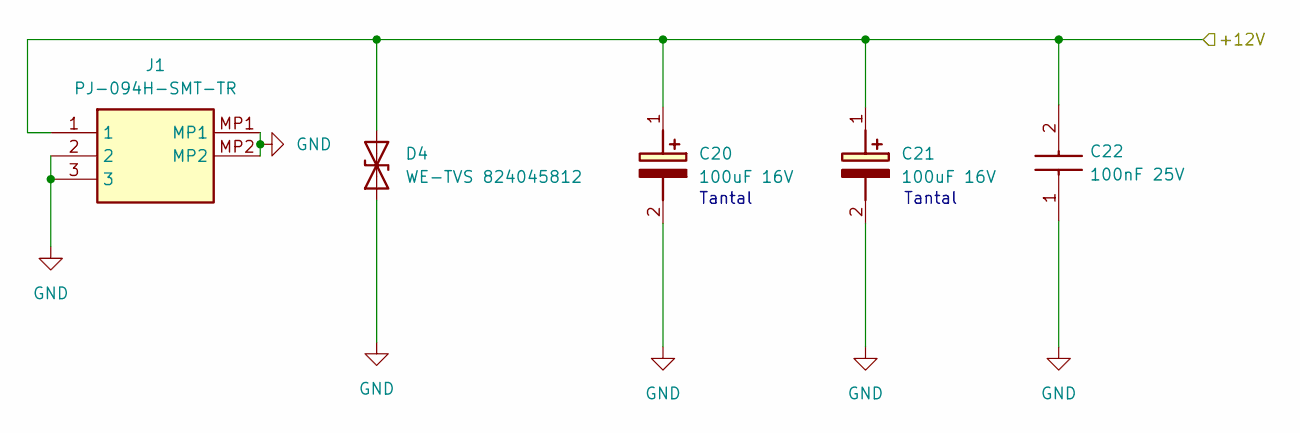
[picture p86: schematic 12V_DC_plug.kicad_sch]

Parts:
C20, C21: 100uF 16V; CAPPM7344X310N; Mouser Part Number 581-TAJD107K016R
C22: 100nF 25V; C_0805_2012Metric_Pad1.18x1.45mm_HandSolder; Mouser Part Number 81-GRM033R71E101KA1J
D4: WE-TVS 824045812; DFN-1610-2
J1: PJ-094H-SMT-TR; PJ094HSMTTR; Mouser Part Number 490-PJ-094H-SMT-TR

Connections:
+12V: C20.1 (+), C21.1 (+), C22.2, D4.2 (A2), J1.1; also elsewhere on the board
GND: C20.2 (-), C21.2 (-), C22.1, D4.1 (A1), J1.2, J1.3, J1.MP1, J1.MP2; also elsewhere on the board

Notes on the sheet:
Tantal
Tantal

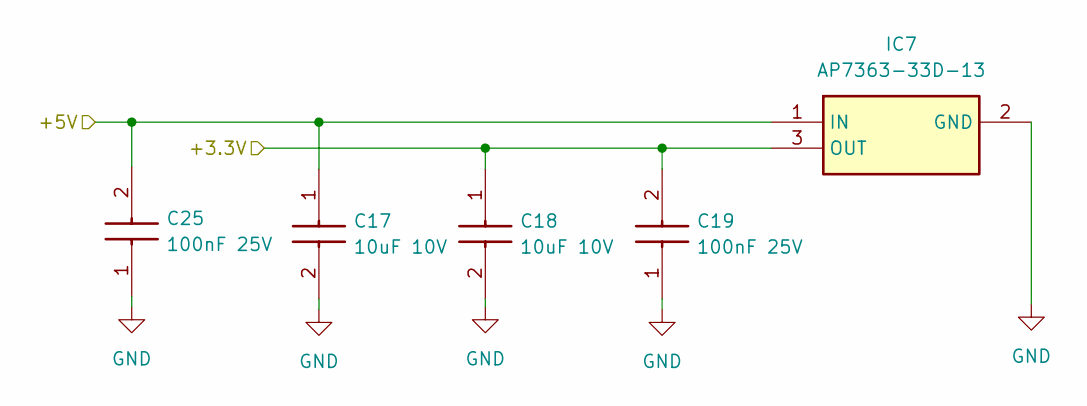
[picture p87: schematic 5V_to_3.3V_ldo.kicad_sch]

Parts:
C17, C18: 10uF 10V; C_0805_2012Metric_Pad1.18x1.45mm_HandSolder; Mouser Part Number 187-CL21A106KPFNNNE
C19, C25: 100nF 25V; C_0805_2012Metric_Pad1.18x1.45mm_HandSolder; Mouser Part Number 81-GRM033R71E101KA1J
IC7: AP7363-33D-13; AP736333D13; Mouser Part Number 621-AP7363-33D-13

Connections:
+3.3V: C18.1, C19.2, IC7.3 (OUT); also elsewhere on the board
+5V: C17.1, C25.2, IC7.1 (IN); also elsewhere on the board
GND: C17.2, C18.2, C19.1, C25.1, IC7.2 (GND); also elsewhere on the board

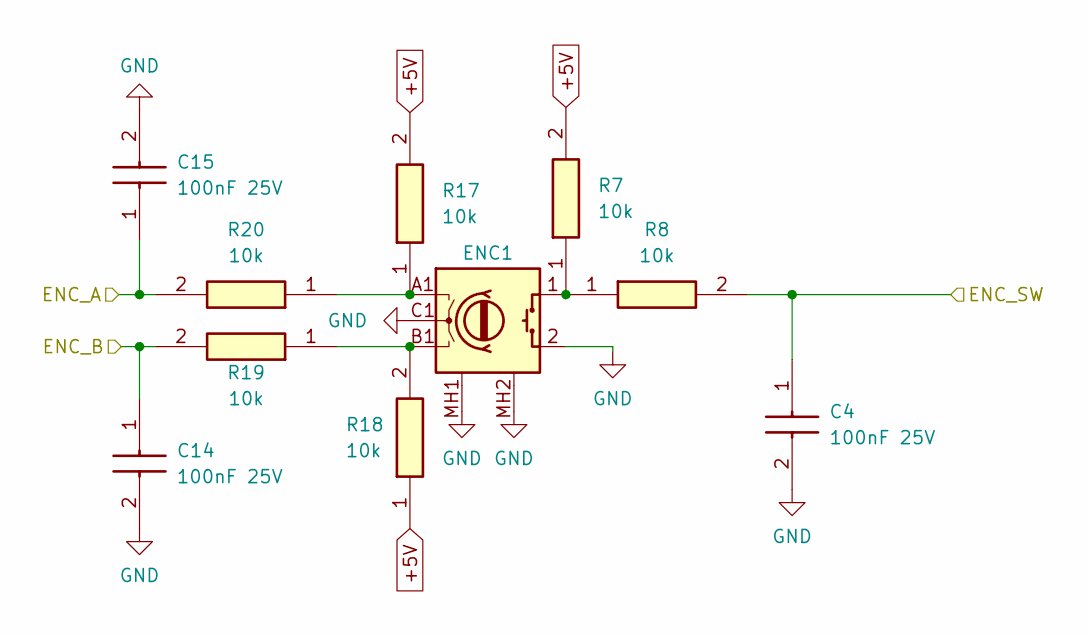
[picture p88: schematic encoder.kicad_sch]

Parts:
C4, C14, C15: 100nF 25V; C_0805_2012Metric_Pad1.18x1.45mm_HandSolder; Mouser Part Number 81-GRM033R71E101KA1J
ENC1: RotaryEncoder_Switch; PEC12R41BBFS0012
R7, R8, R17, R18, R19, R20: 10k; R_0805_2012Metric_Pad1.20x1.40mm_HandSolder; Mouser Part Number 667-ERJ-UP6D5101V

Connections:
+5V: R7.2, R17.2, R18.1; also elsewhere on the board
ENC_A: C15.1, R20.2; also elsewhere on the board
ENC_B: C14.1, R19.2; also elsewhere on the board
ENC_SW: C4.1, R8.2; also elsewhere on the board
GND: C4.2, C14.2, C15.2, ENC1.2, ENC1.C1, ENC1.MH1, ENC1.MH2 (MH12); also elsewhere on the board
unnamed: ENC1.1, R7.1, R8.1
unnamed: ENC1.A1, R17.1, R20.1
unnamed: ENC1.B1, R18.2, R19.1

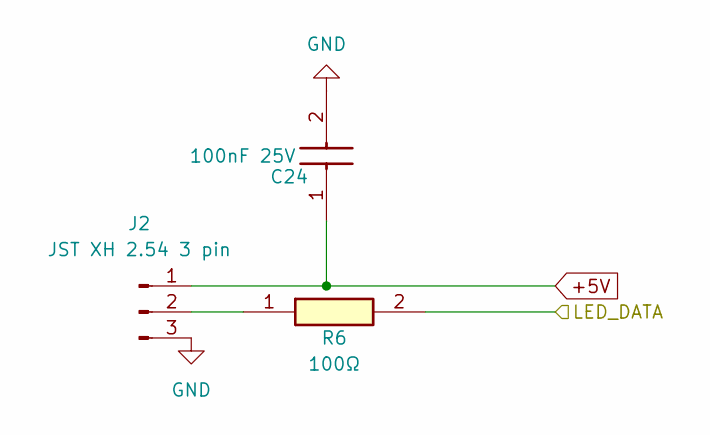
[picture p89: schematic LED_strip.kicad_sch]

Parts:
C24: 100nF 25V; C_0805_2012Metric_Pad1.18x1.45mm_HandSolder; Mouser Part Number 81-GRM033R71E101KA1J
J2: JST XH 2.54 3 pin; JST_XH_S3B-XH-A-1_1x03_P2.50mm_Horizontal
R6: 100Ω; R_0805_2012Metric_Pad1.20x1.40mm_HandSolder; Mouser Part Number 667-ERJ-UP6D5101V

Connections:
+5V: C24.1, J2.1; also elsewhere on the board
GND: C24.2, J2.3; also elsewhere on the board
LED_DATA: R6.2; also elsewhere on the board
unnamed: J2.2, R6.1

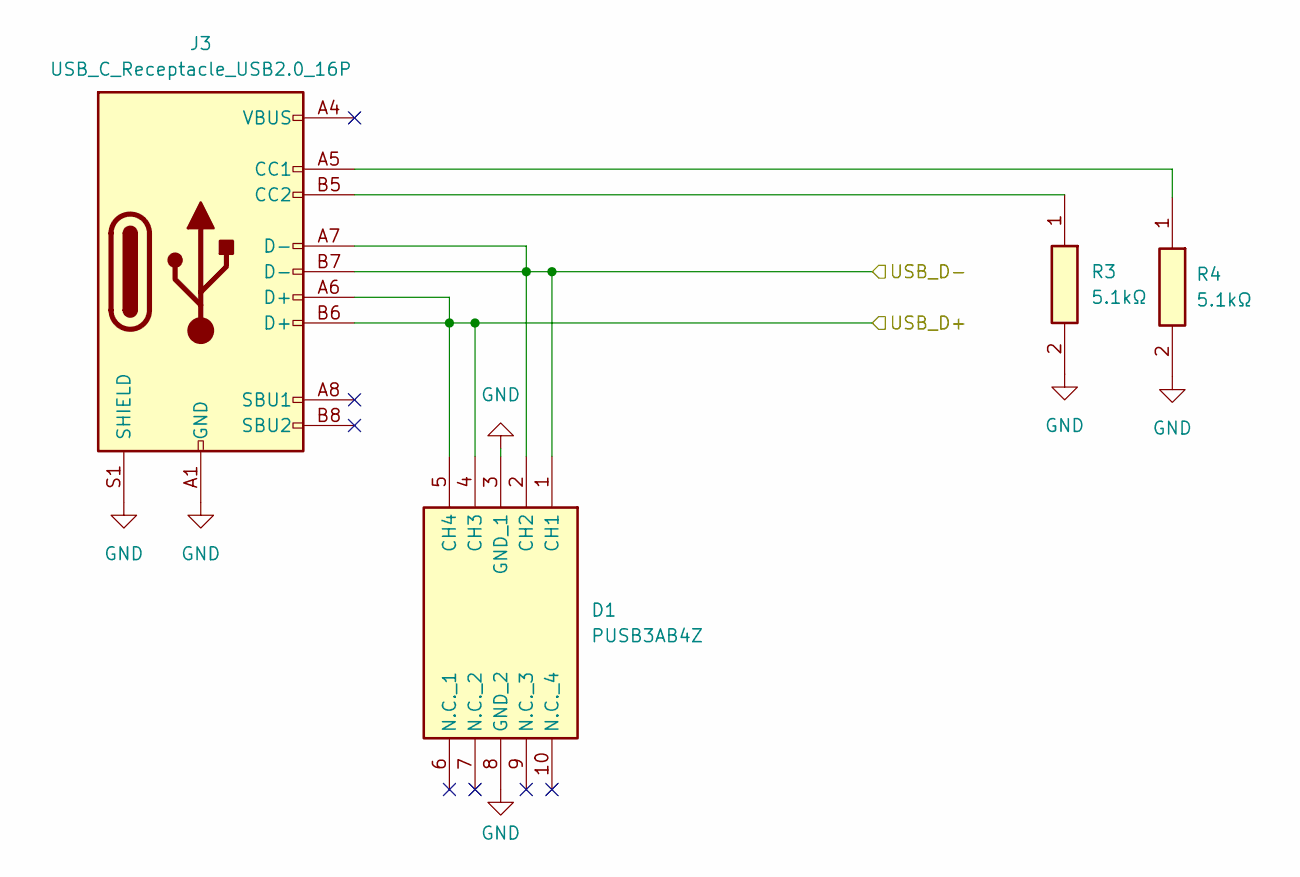
[picture p90: schematic usb_c_to_program.kicad_sch]

Parts:
D1: PUSB3AB4Z; SON50P100X250X50-10N; Mouser Part Number 771-PUSB3AB4Z
J3: USB_C_Receptacle_USB2.0_16P; USB_C_Receptacle_GCT_USB4105-xx-A_16P_TopMnt_Horizontal
R3, R4: 5.1kΩ; R_0805_2012Metric_Pad1.20x1.40mm_HandSolder; Mouser Part Number 667-ERJ-UP6D5101V

Connections:
GND: D1.3 (GND_1), D1.8 (GND_2), J3.A1 (GND), J3.A12 (GND), J3.B1 (GND), J3.B12 (GND), J3.S1 (SHIELD), R3.2, R4.2; also elsewhere on the board
unnamed: J3.A5 (CC1), R4.1
unnamed: J3.B5 (CC2), R3.1
USB_D+: D1.4 (CH3), D1.5 (CH4), J3.A6 (D+), J3.B6 (D+); also elsewhere on the board
USB_D-: D1.1 (CH1), D1.2 (CH2), J3.A7 (D-), J3.B7 (D-); also elsewhere on the board

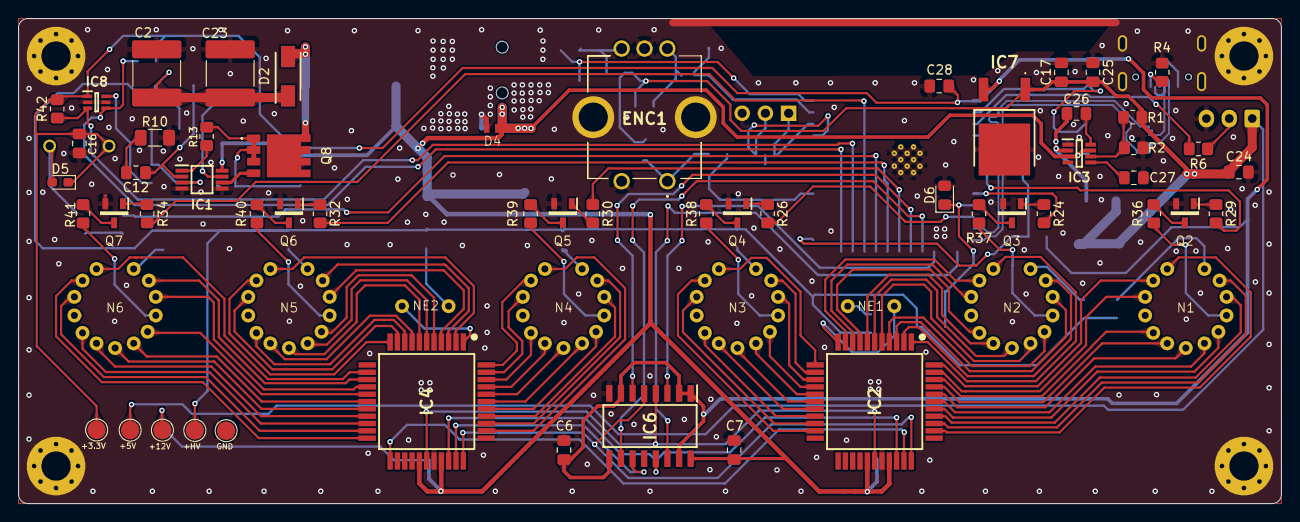
[picture p91: board nixie_alarm_main_board.kicad_pcb from above]

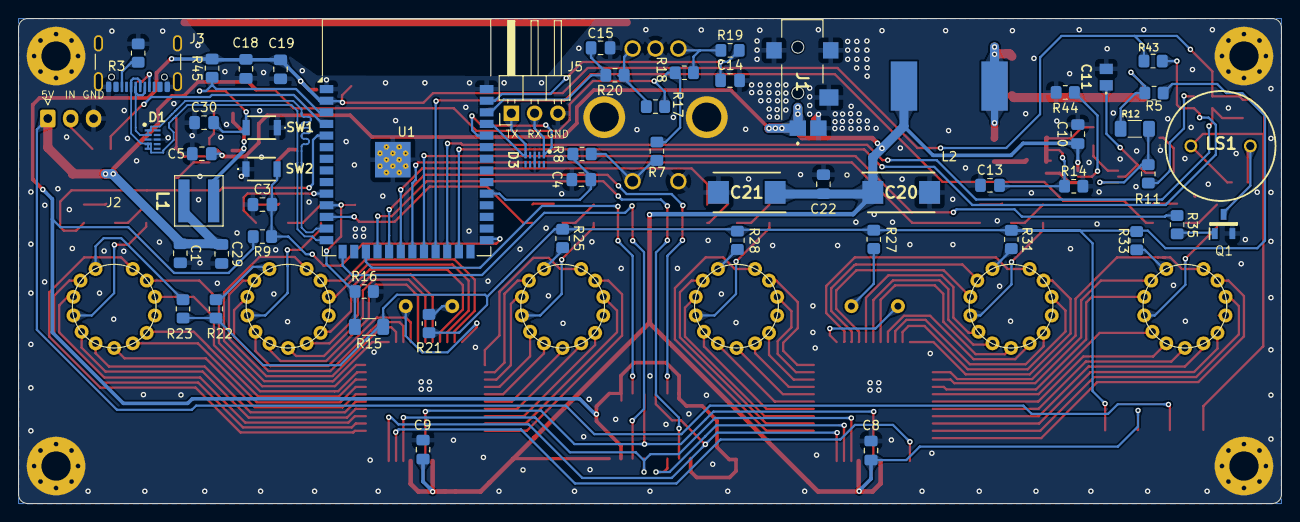
[picture p92: board nixie_alarm_main_board.kicad_pcb from below]

Board: 2 copper layers, 138.0 x 53.0 mm, 124 parts (57 on the bottom side), 144 nets.
