wojciechpaderewski/Nixie_alarm_clock/(commit log)

2024-02-24 nixie tube params
2024-08-13 schematic v1
    [12V_DC_plug.kicad_sch, 12V_to_180V_conv.kicad_sch, 12V_to_5V_conv.kicad_sch, 12V_to_HV_conv.kicad_sch, 433mhz.kicad_sch, 5V_to_12V_conv.kicad_sch, 5V_to_3.3V_ldo.kicad_sch, LED_strip.kicad_sch]
2024-09-02 filter caps
    [12V_to_5V_conv.kicad_sch, 12V_to_HV_conv.kicad_sch, 5V_to_3.3V_ldo.kicad_sch, LED_strip.kicad_sch, buzzer.kicad_sch, encoder.kicad_sch, nixie.kicad_sch, nixie_alarm_main_board.kicad_pcb]
2024-09-03 new rezistors
    [12V_DC_plug.kicad_sch, 12V_to_5V_conv.kicad_sch, 12V_to_HV_conv.kicad_sch, 5V_to_3.3V_ldo.kicad_sch, LED_strip.kicad_sch, buzzer.kicad_sch, encoder.kicad_sch, nixie.kicad_sch]
2024-09-03 new caps footprint
    [12V_DC_plug.kicad_sch, 5V_to_3.3V_ldo.kicad_sch, LED_strip.kicad_sch, buzzer.kicad_sch, encoder.kicad_sch, nixie.kicad_sch]
2024-09-03 new hv conv desgin
    [12V_DC_plug.kicad_sch, 12V_to_5V_conv.kicad_sch, 12V_to_HV_conv.kicad_sch, 5V_to_3.3V_ldo.kicad_sch, LED_strip.kicad_sch, buzzer.kicad_sch, encoder.kicad_sch, nixie.kicad_sch]
2024-09-04 traces for nixie tubes
    [12V_to_5V_conv.kicad_sch, 12V_to_HV_conv.kicad_sch, nixie.kicad_sch, nixie_alarm_main_board.kicad_pcb]
2024-09-07 all components in board footprint
    [12V_to_HV_conv.kicad_sch, encoder.kicad_sch, nixie_alarm_main_board.kicad_pcb, nixie_alarm_main_board.kicad_sch]
2024-09-08 board v1
    [nixie.kicad_sch, nixie_alarm_main_board.kicad_pcb, nixie_alarm_main_board.kicad_sch]
2024-09-10 new layout
    [12V_to_HV_conv.kicad_sch, nixie_alarm_main_board.kicad_pcb]
2024-09-11 hv section
    [12V_DC_plug.kicad_sch, 12V_to_5V_conv.kicad_sch, 12V_to_HV_conv.kicad_sch, 5V_to_3.3V_ldo.kicad_sch, LED_strip.kicad_sch, buzzer.kicad_sch, encoder.kicad_sch, nixie.kicad_sch]
2024-09-12 new board v1
    [12V_DC_plug.kicad_sch, 12V_to_5V_conv.kicad_sch, 12V_to_HV_conv.kicad_sch, 5V_to_3.3V_ldo.kicad_sch, LED_strip.kicad_sch, buzzer.kicad_sch, encoder.kicad_sch, nixie.kicad_sch]
2024-09-14 elements sings fixed
    [nixie_alarm_main_board.kicad_pcb]
2024-09-15 add more detalis
    [Debug_UART.kicad_sch, LED_strip.kicad_sch, nixie_alarm_main_board.kicad_pcb, nixie_alarm_main_board.kicad_sch]
2024-09-17 copper border
    [Debug_UART.kicad_sch, nixie_alarm_main_board.kicad_pcb, nixie_alarm_main_board.kicad_sch]
2024-09-18 little fixes
    [nixie_alarm_main_board.kicad_pcb]
2024-09-19 label fix
    [nixie_alarm_main_board.kicad_pcb]
2024-10-06 tvs protection try
    [12V_DC_plug.kicad_sch, nixie_alarm_main_board.kicad_pcb, usb_c_to_program.kicad_sch]
2024-10-07 tvs added
    [12V_DC_plug.kicad_sch, Debug_UART.kicad_sch, nixie_alarm_main_board.kicad_pcb, nixie_alarm_main_board.kicad_sch, usb_c_to_program.kicad_sch]
2024-10-09 fixes added
    [12V_DC_plug.kicad_sch, 12V_to_5V_conv.kicad_sch, 12V_to_HV_conv.kicad_sch, 5V_to_3.3V_ldo.kicad_sch, Debug_UART.kicad_sch, LED_strip.kicad_sch, buzzer.kicad_sch, encoder.kicad_sch]
2024-10-09 final fixes
    [12V_DC_plug.kicad_sch, 12V_to_5V_conv.kicad_sch, 12V_to_HV_conv.kicad_sch, 5V_to_3.3V_ldo.kicad_sch, Debug_UART.kicad_sch, LED_strip.kicad_sch, buzzer.kicad_sch, encoder.kicad_sch]
2024-10-09 little adujstments
    [nixie_alarm_main_board.kicad_pcb]
2024-10-14 new border
    [nixie_alarm_main_board.kicad_pcb]
2024-10-14 dc plug module describe
    [12V_DC_plug.kicad_sch, nixie_alarm_main_board.kicad_pcb]
2024-10-16 new conv capacitors
    [12V_DC_plug.kicad_sch, 12V_to_5V_conv.kicad_sch, 12V_to_HV_conv.kicad_sch, 5V_to_3.3V_ldo.kicad_sch, Debug_UART.kicad_sch, LED_strip.kicad_sch, buzzer.kicad_sch, encoder.kicad_sch]
2024-10-16 border fix and drc check
    [nixie_alarm_main_board-B_Cu.gbr, nixie_alarm_main_board-B_Mask.gbr, nixie_alarm_main_board-B_Paste.gbr, nixie_alarm_main_board-B_Silkscreen.gbr, nixie_alarm_main_board-Edge_Cuts.gbr, nixie_alarm_main_board-F_Cu.gbr, nixie_alarm_main_board-F_Mask.gbr, nixie_alarm_main_board-F_Paste.gbr]
2024-10-16 koncepcja układu
    [12V_to_HV_conv.kicad_sch, nixie.kicad_sch, nixie_alarm_main_board.kicad_pcb]
2024-10-21 zener diode on fb
    [12V_to_HV_conv.kicad_sch, LED_strip.kicad_sch, buzzer.kicad_sch, nixie_alarm_main_board.kicad_pcb]
2024-11-03 board v2
    [12V_to_5V_conv.kicad_sch, 12V_to_HV_conv.kicad_sch, LED_strip.kicad_sch, buzzer.kicad_sch, encoder.kicad_sch, nixie.kicad_sch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]
2024-11-14 marged with board v2
    [12V_DC_plug.kicad_sch, 12V_to_5V_conv.kicad_sch, 12V_to_HV_conv.kicad_sch, Debug_UART.kicad_sch, LED_strip.kicad_sch, bom.csv, buttons.kicad_sch, buzzer.kicad_sch]
2024-11-18 encoder i buzzer
2024-11-27 rejestry i ledy
2024-11-27 PCB added
